garrettsworkshop/RAM2GS/(threads)

Thread 2 (2025-06-27):

Discrepancy between part# and voltage?

rdolbeau, 2025-06-27:
Hello,

Looking at your design (trying to figure out how you made work SDRAM with an Apple II - thanks for sharing!), there is something I do not understand on the wiring of the LCMXO2-640HC-4TG100C part in the LCMXO2 version.

The schematics indicates the aforementioned LCMXO2-640HC-4TG100C and point to the matching LCSC part.
However, the VCC for this part is wired to a 1.2V power supply.
But from my reading of the "MachXO2 Family Data Sheet", the HC variants require a 2.5V or 3.3V VCC, while the HE and ZE variants require a 1.2V VCC. I don't see a HE variant in the datasheet, there is some ZE though at a lower speed grades.

Is the intent to use a ZE part?

Cordially,
