garrettsworkshop/RAM2GS/Hardware/LCMXO/Documentation/RAM2GS.4201D.LCMXO-Schematic.pdf

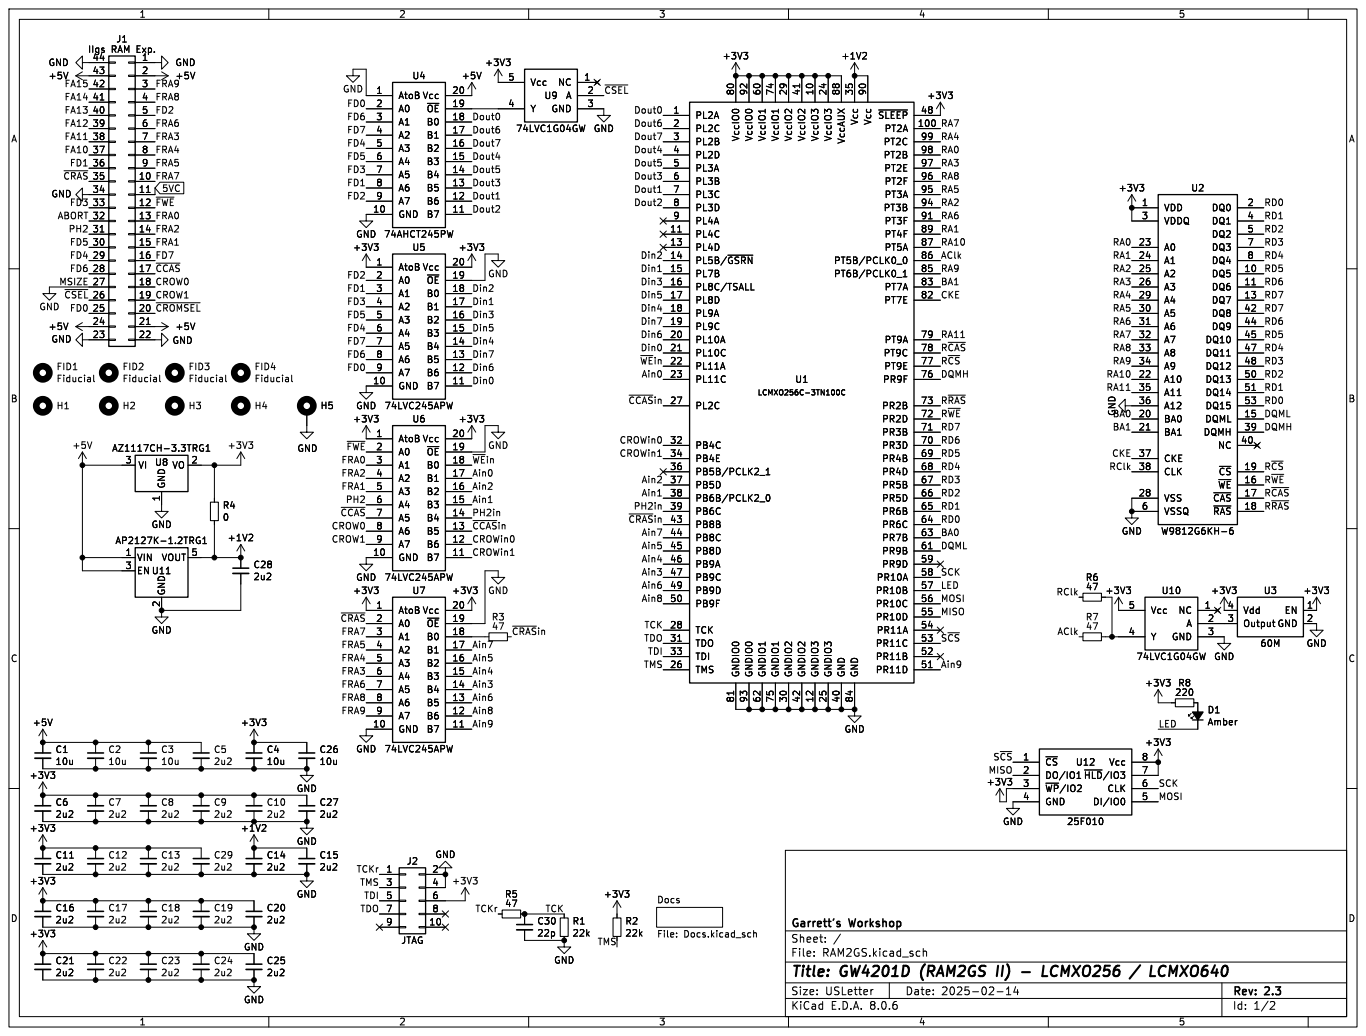
[picture p4: page 1]

File: RAM2GS.kicad_sch Sheet: / Garrett's Workshop Docs File: Docs.kicad_sch

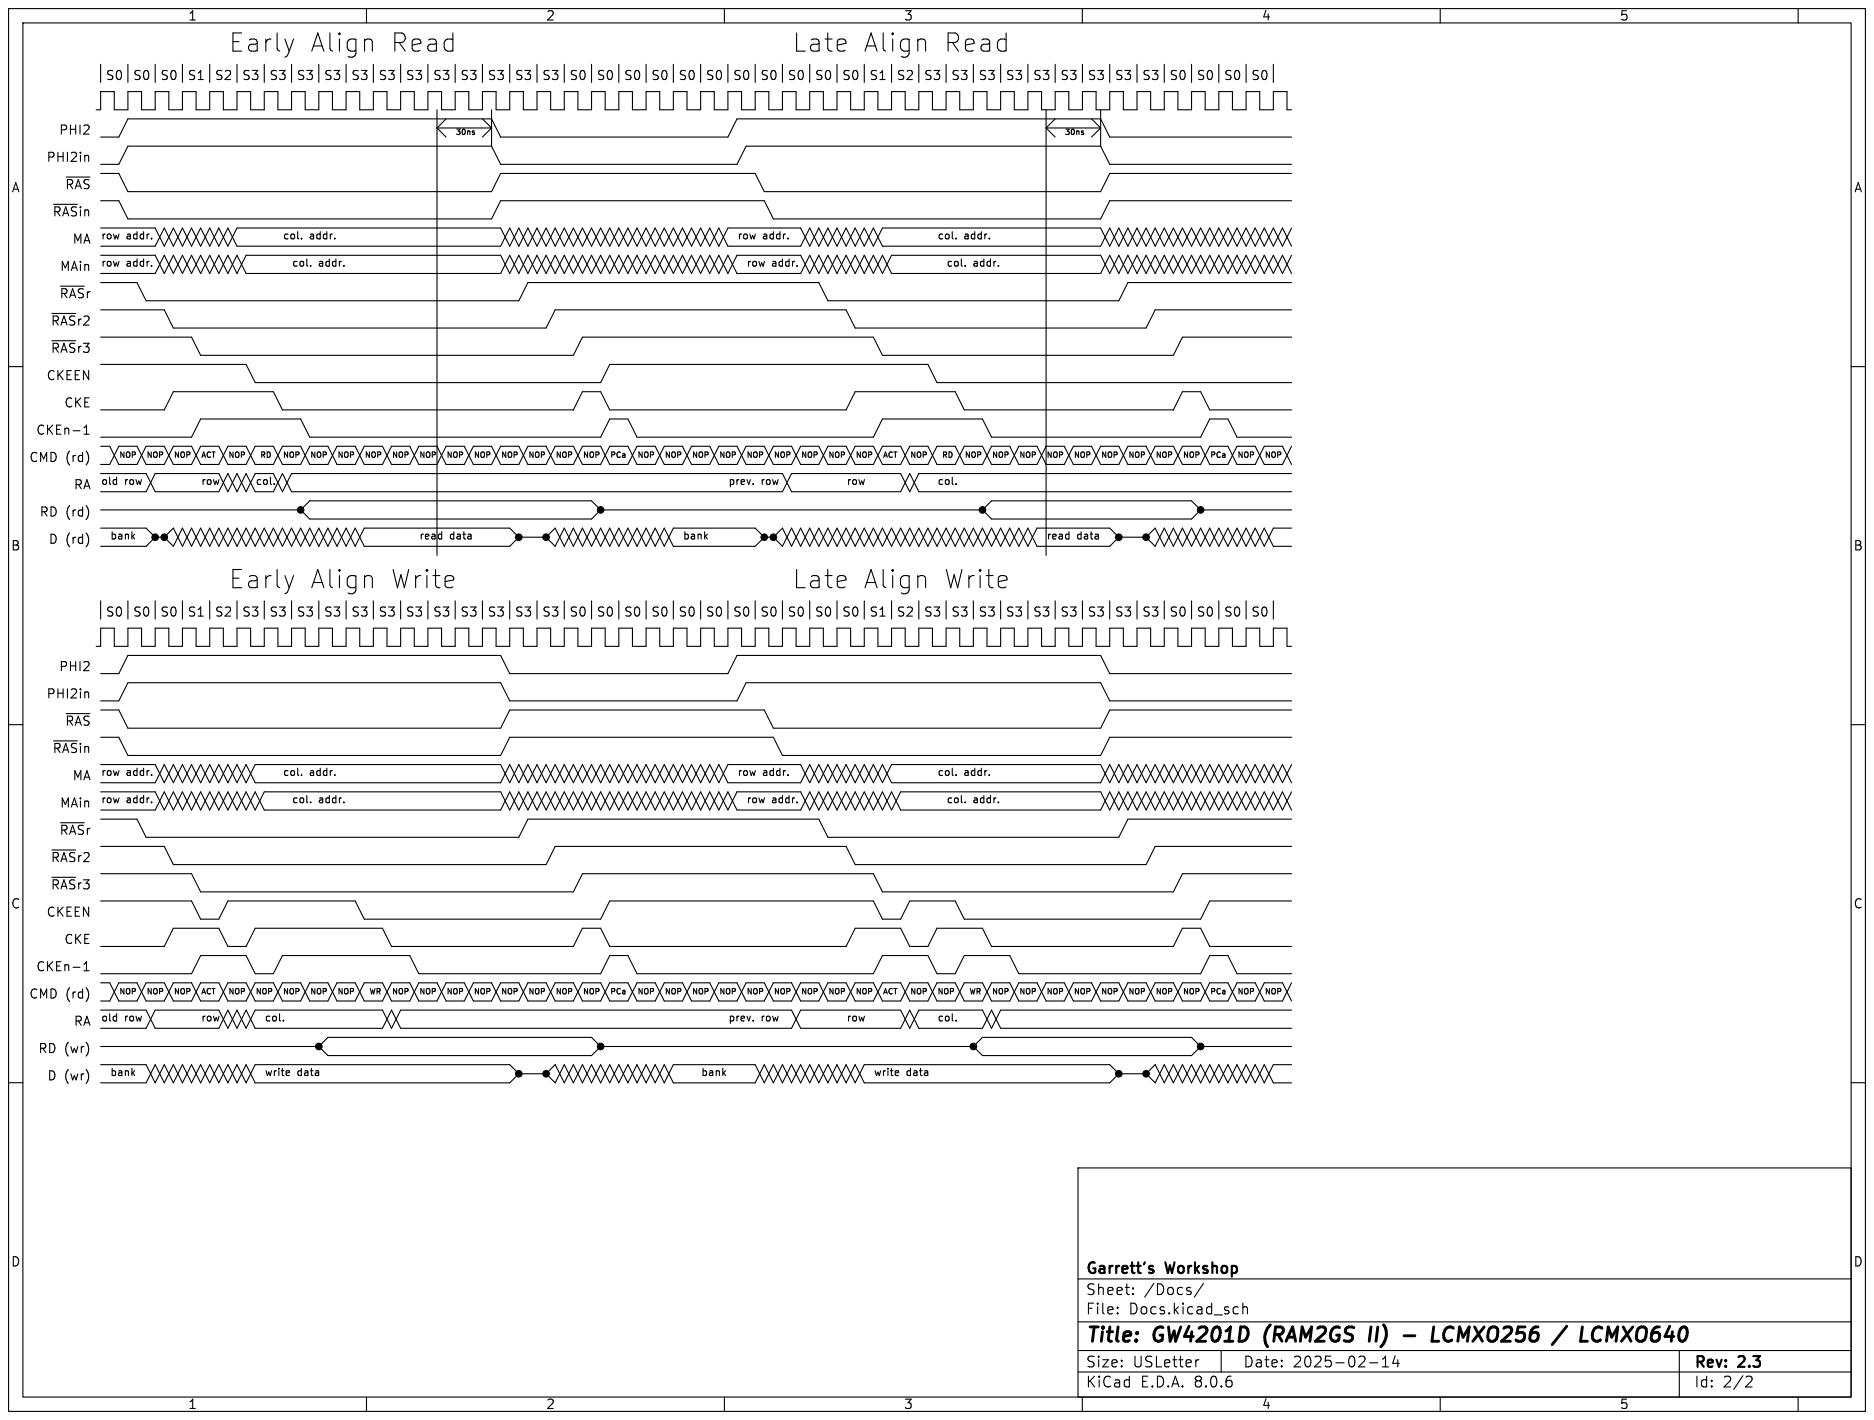
[picture p5: page 2]

col. addr. S3 S3 S3 S3 Early Align Write

~{RAS}r2 MAin ~{RAS}r CKEn-1 CKEEN

File: Docs.kicad_sch Sheet: /Docs/ Garrett's Workshop
