garrettsworkshop/RAM2GS/Hardware/LCMXO2/Documentation/RAM2GS.4201D.LCMXO2-Schematic.pdf

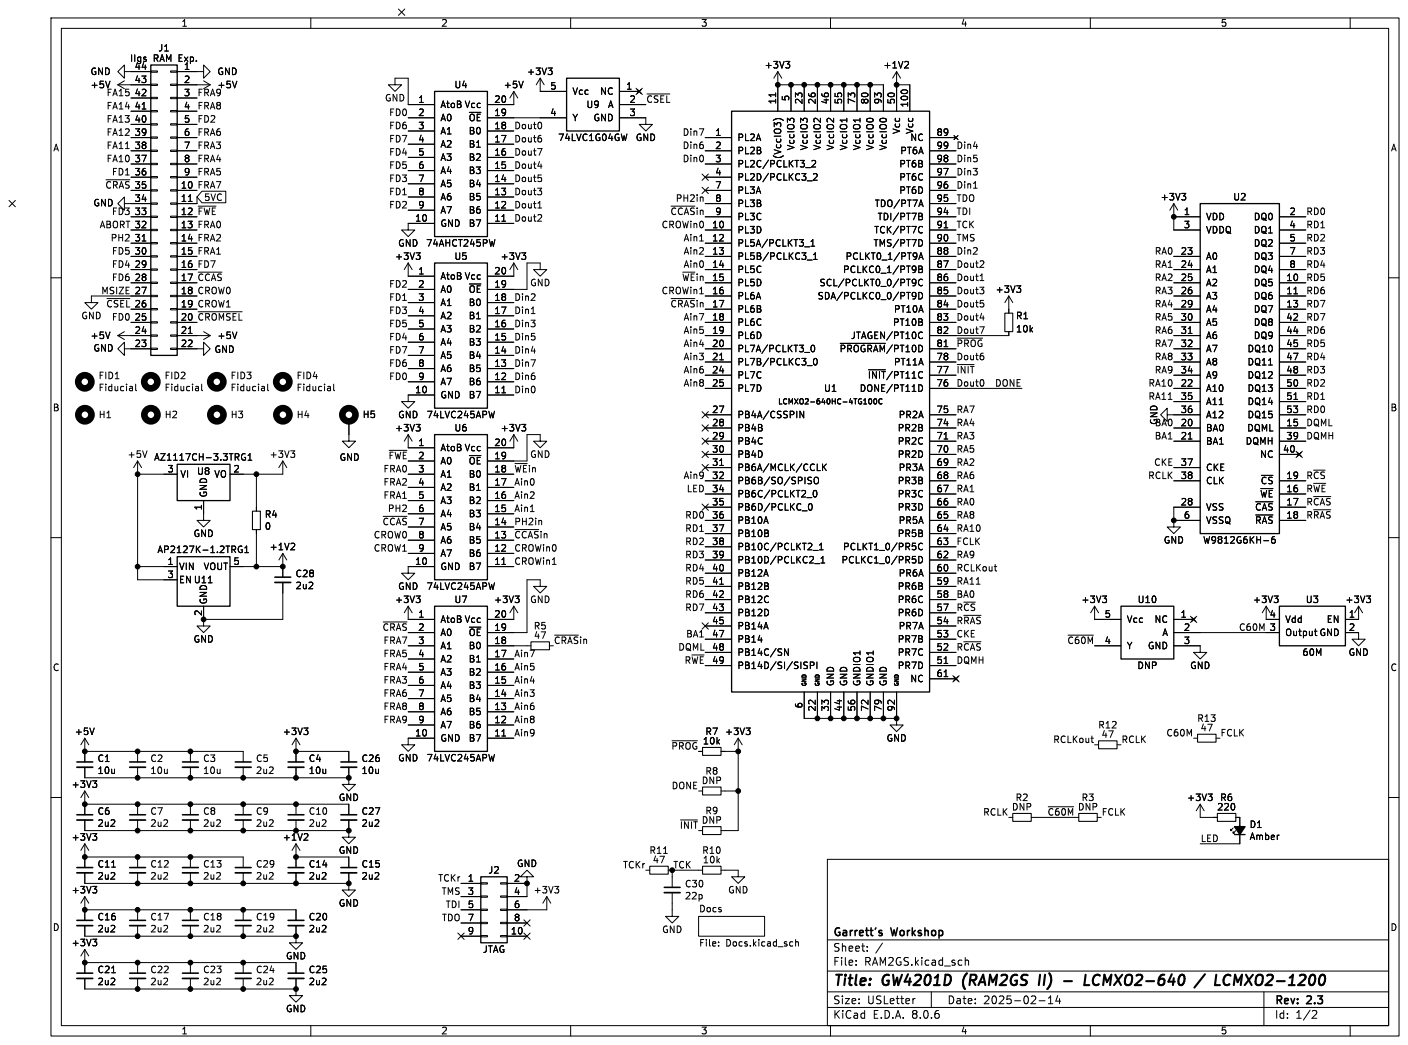
[picture p6: page 1]

5 Vcc 50 PR7D 51 PR7C 52 PR7B 53 PR7A 54 VccIO1 55 GNDIO1 56 PR6D 57 PR6C 58 PR6B 59 GND 6 PR6A 60 NC 61 PCLKC1_0/PR5D 62 PCLKT1_0/PR5C 63 PR5B 64 PR5A 65 PR3D 66 PR3C 67 PR3B 68 PR3A 69 PL3A 7 PR2D 70 PR2C 71 GNDIO1 72 VccIO1 73 PR2B 74 PR2A 75 DONE/PT11D 76 ~{INIT}/PT11C 77 PT11A 78 GND 79 PL3B 8 VccIO0 80

FID4 Fiducial C9

2 EN 3 VOUT 5 GND GND

File: RAM2GS.kicad_sch Sheet: / Garrett's Workshop Docs File: Docs.kicad_sch C23

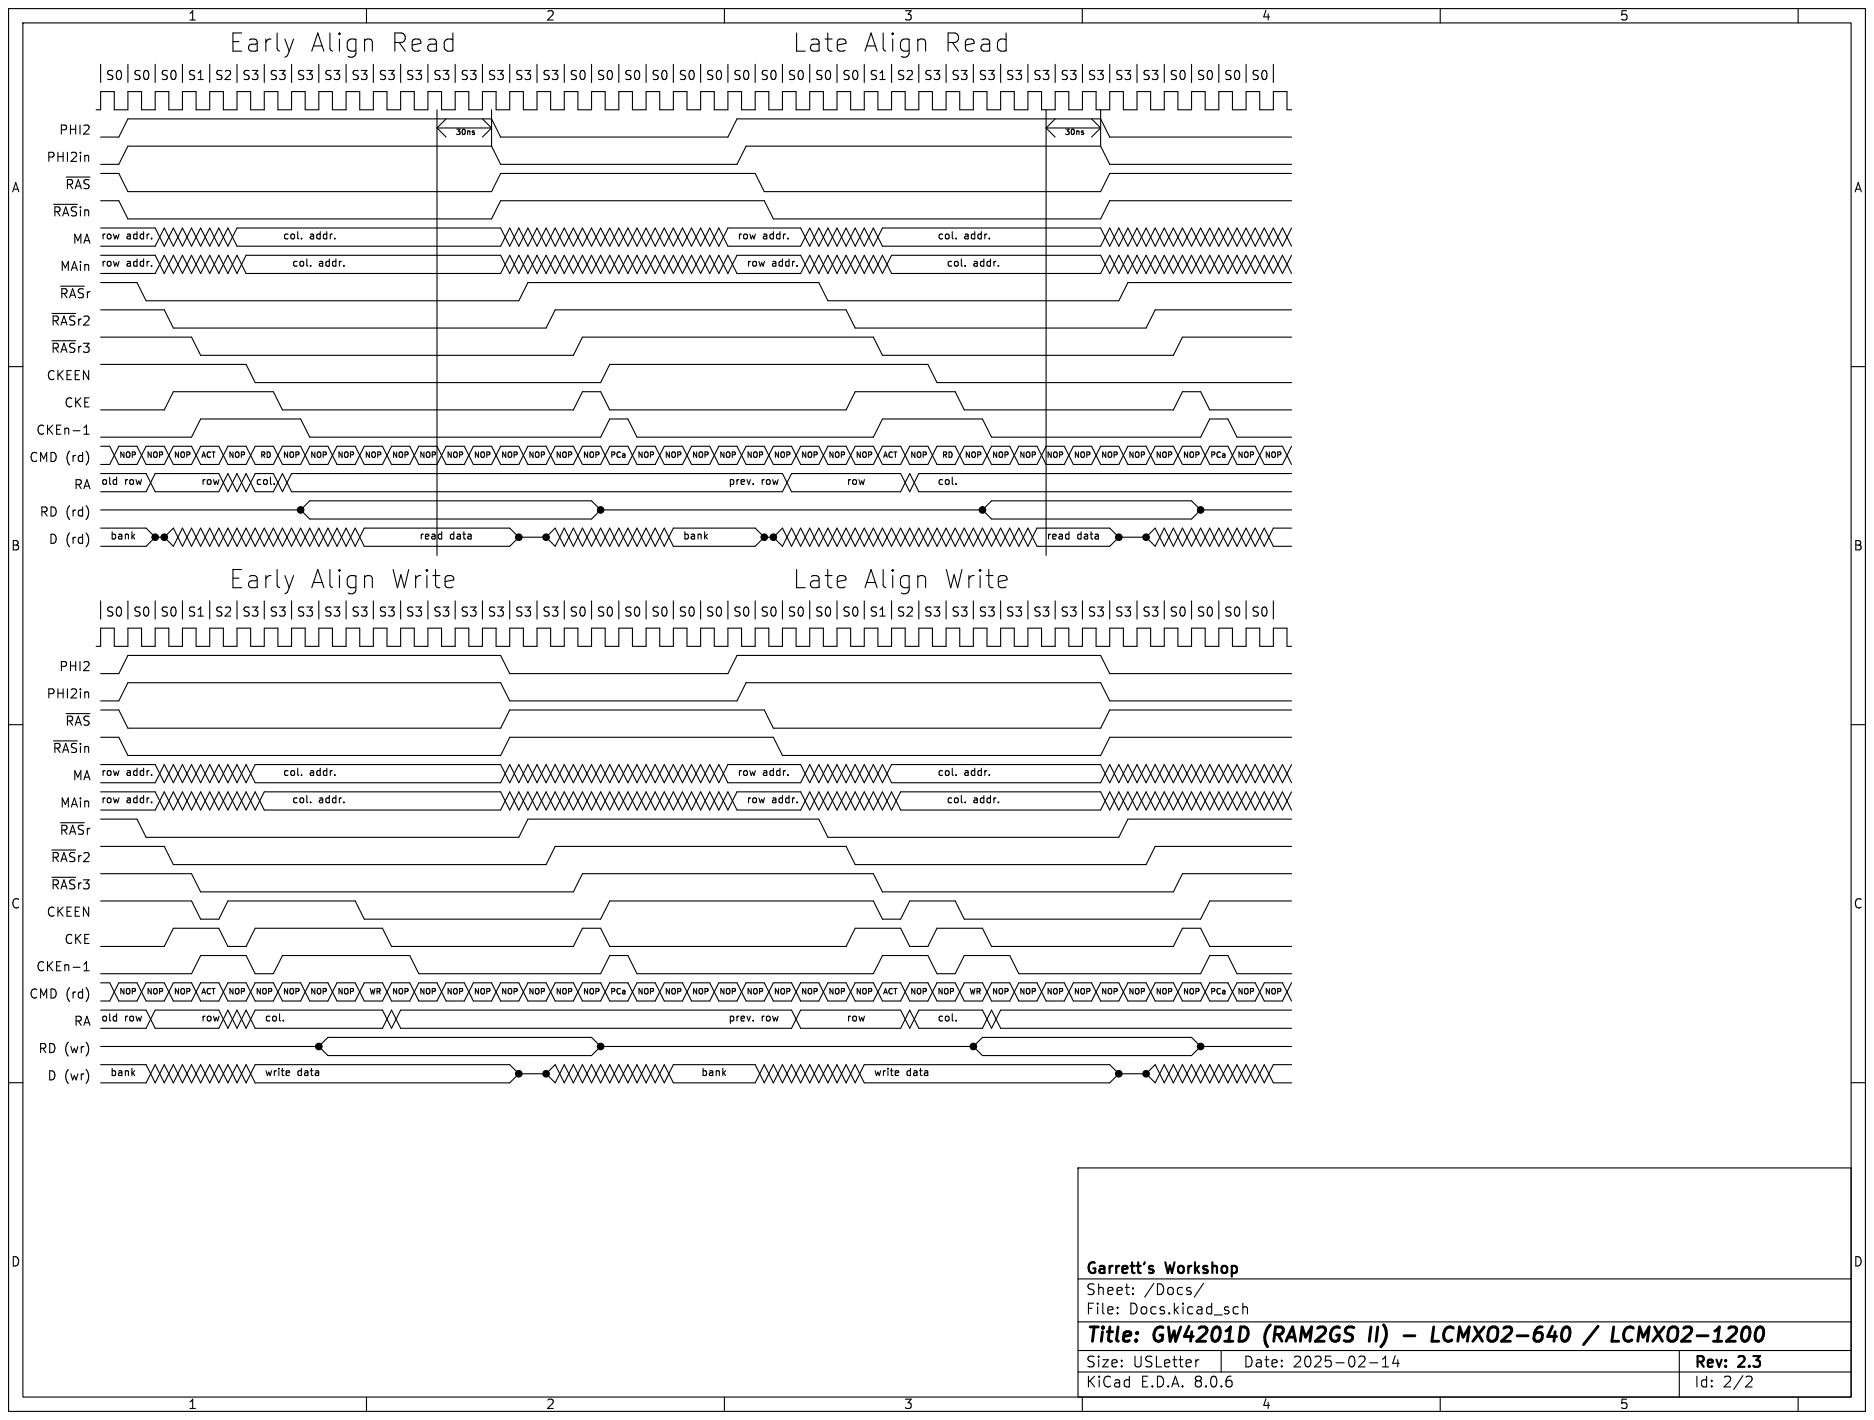
[picture p7: page 2]

~{RAS}r3S0 CKE CKEn-1 CMD (rd)

row addr. row addr. MAin row addr. ~{RAS}r MA row addr. S0 S1

col. addr. col. addr. S0

~{RAS}r2
NOP CKEn-1 ~{RAS}r3 CKEEN

File: Docs.kicad_sch Sheet: /Docs/ Garrett's Workshop
