garrettsworkshop/RAM2GS/Hardware/MAX/Documentation/RAM2GS.4201D.MAX-Schematic.pdf

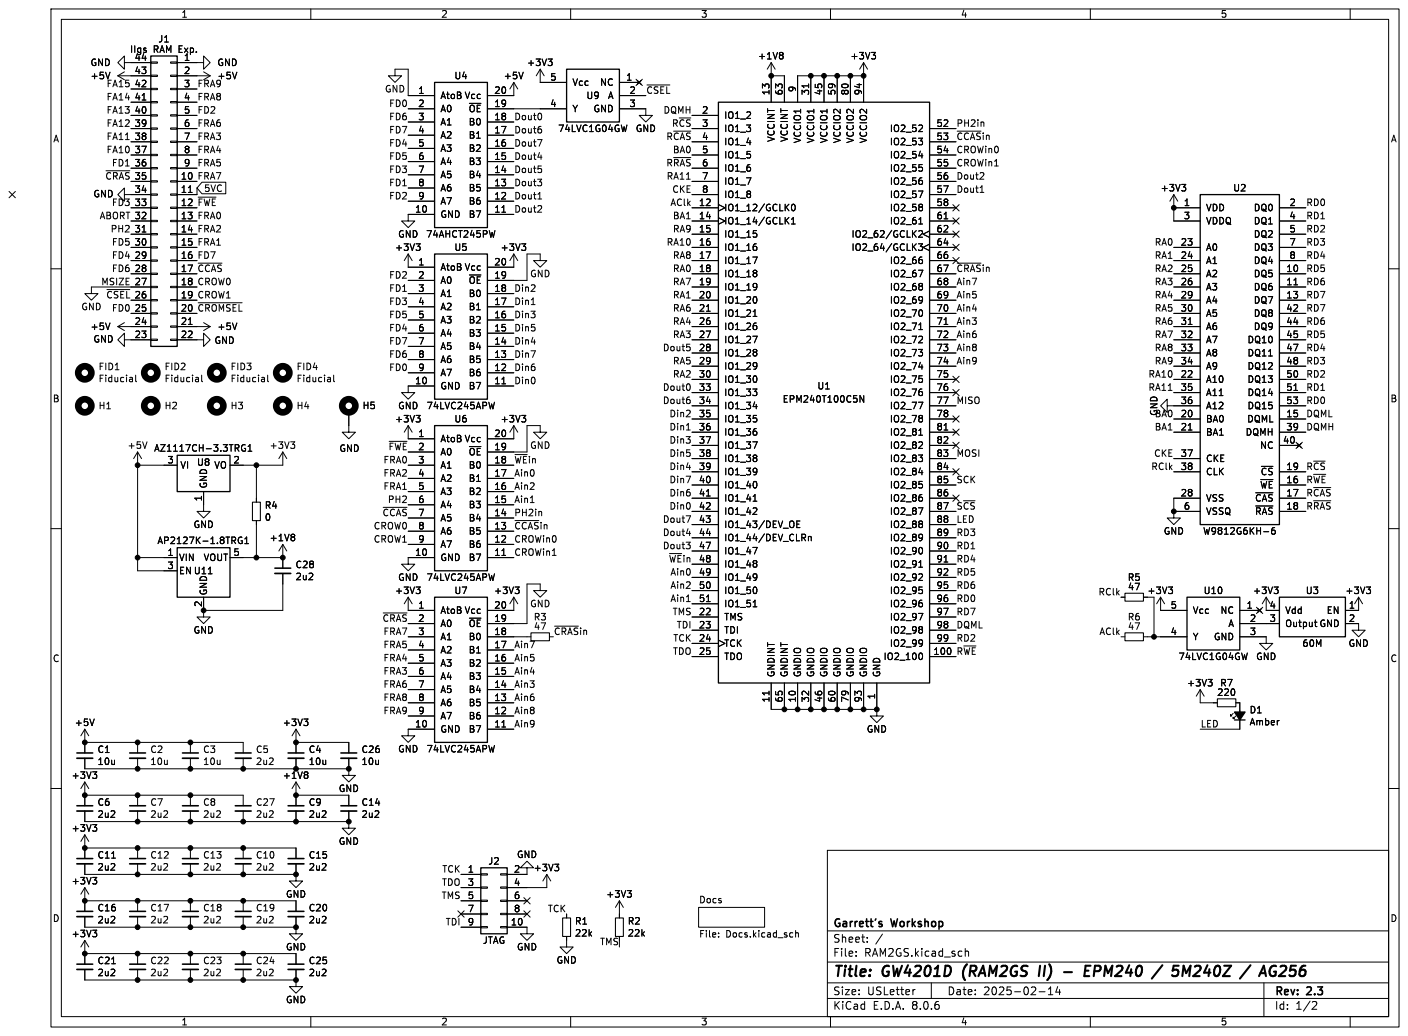
[picture p8: page 1]

R~{CAS} LED MOSI SCK

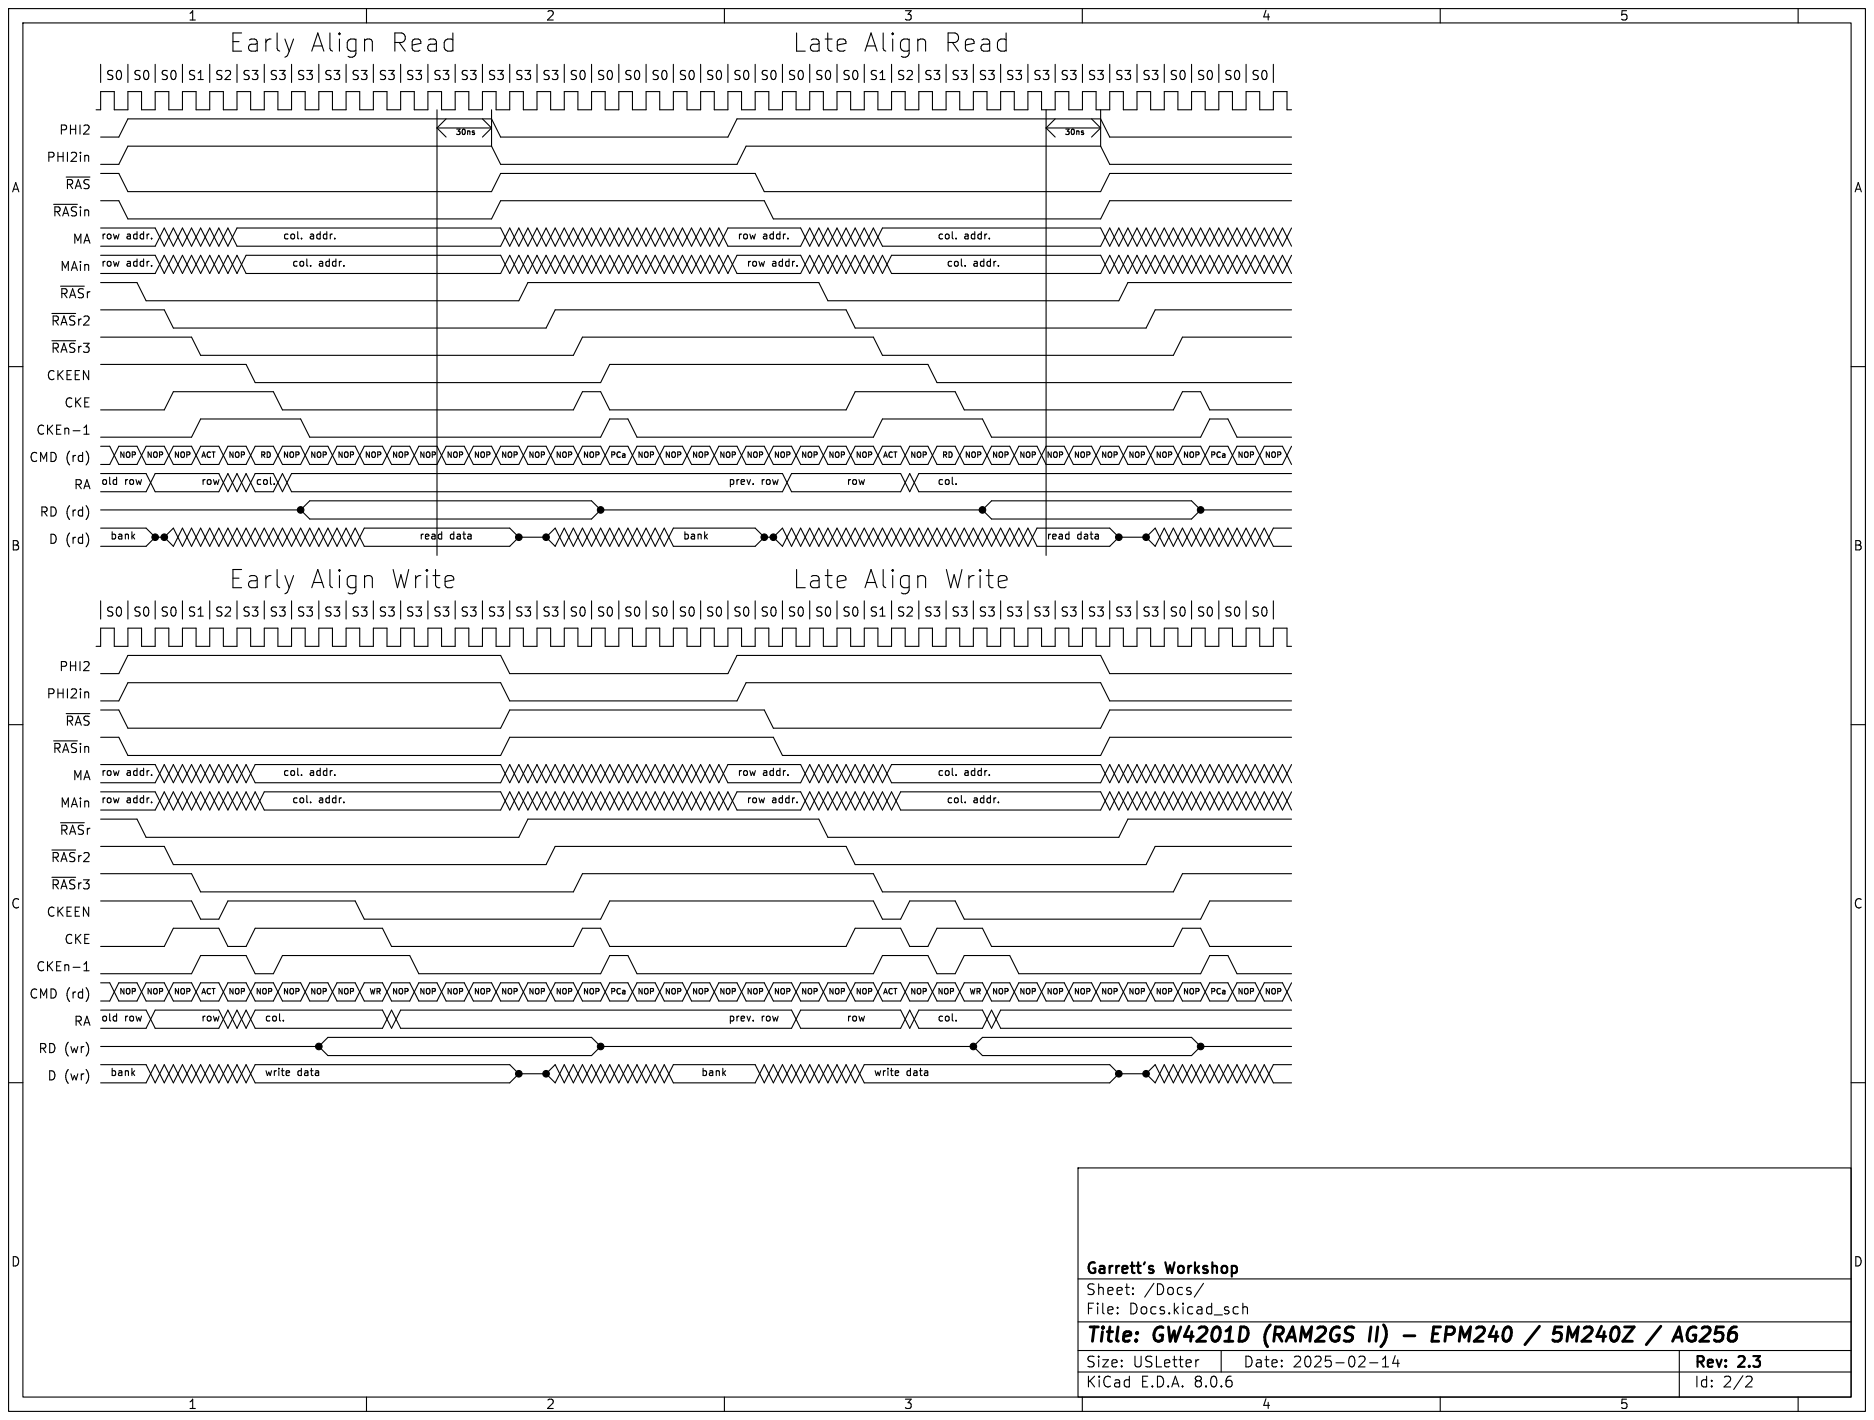
[picture p9: page 2]

PHI2 ~{RAS} MA MAin PHI2in ~{RAS}in

~{RAS}r3 MAin row addr. CKE CKEEN

row addr. row addr. ~{RAS}r2
~{RAS}r3 CKEn-1 RD (rd) RA

row addr.

col. addr. Early Align Write

File: Docs.kicad_sch Sheet: /Docs/ Garrett's Workshop
