garrettsworkshop/RAM2GS/Hardware/LCMXO/Documentation/RAM2GS.4201D.LCMXO-Placement.pdf

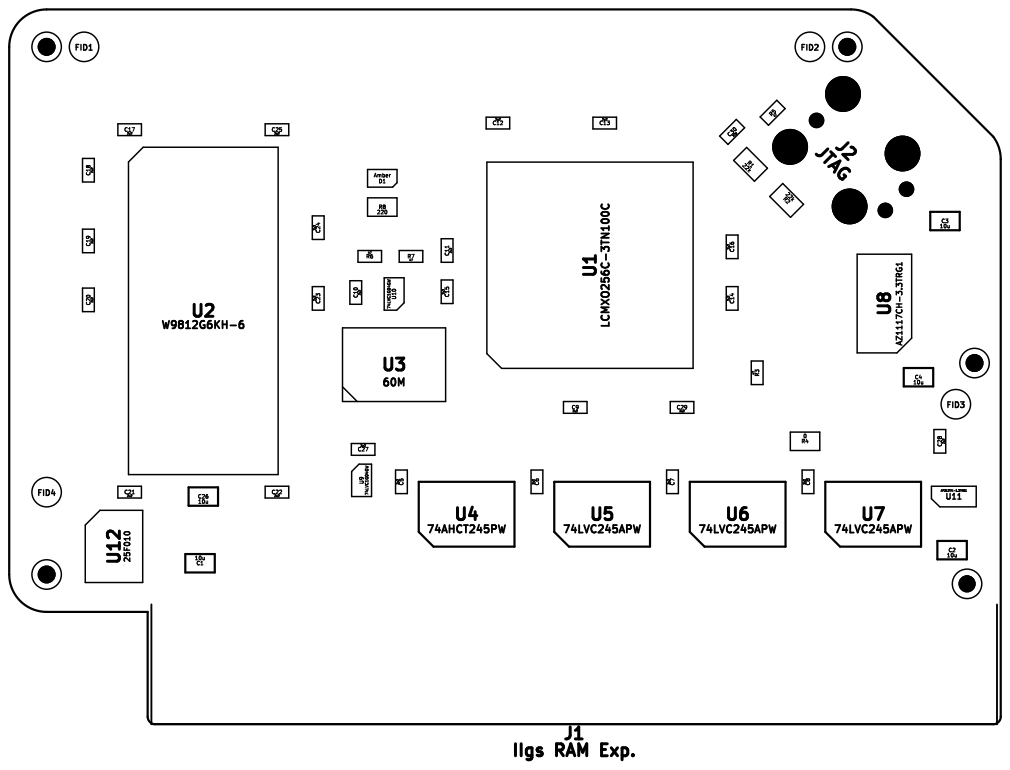
[picture p10: page 1]
