garrettsworkshop/RAM2GS/Hardware/LCMXO2/Documentation/RAM2GS.4201D.LCMXO2-Placement.pdf

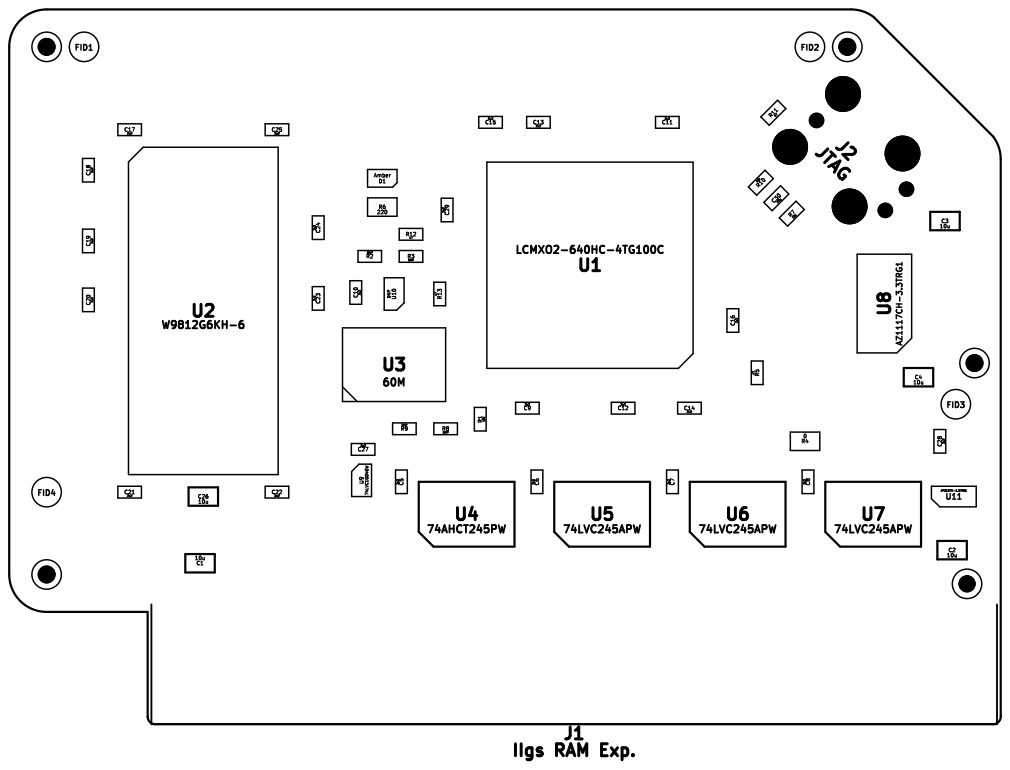
[picture p11: page 1]
