garrettsworkshop/RAM2GS/Hardware/MAX/Documentation/RAM2GS.4201D.MAX-Placement.pdf

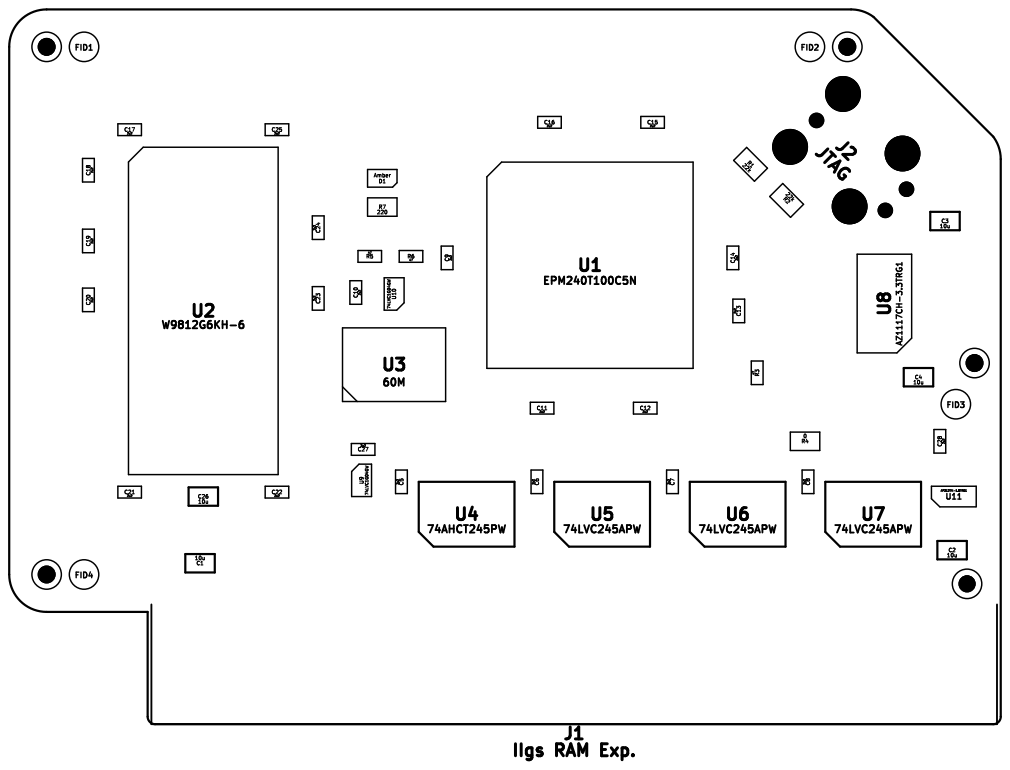
[picture p12: page 1]
