garrettsworkshop/RAM2GS/Hardware/MAX/RAM2GS.kicad_pcb

## KiCad design Hardware/MAX/RAM2GS.kicad_pcb (2025-02-23)

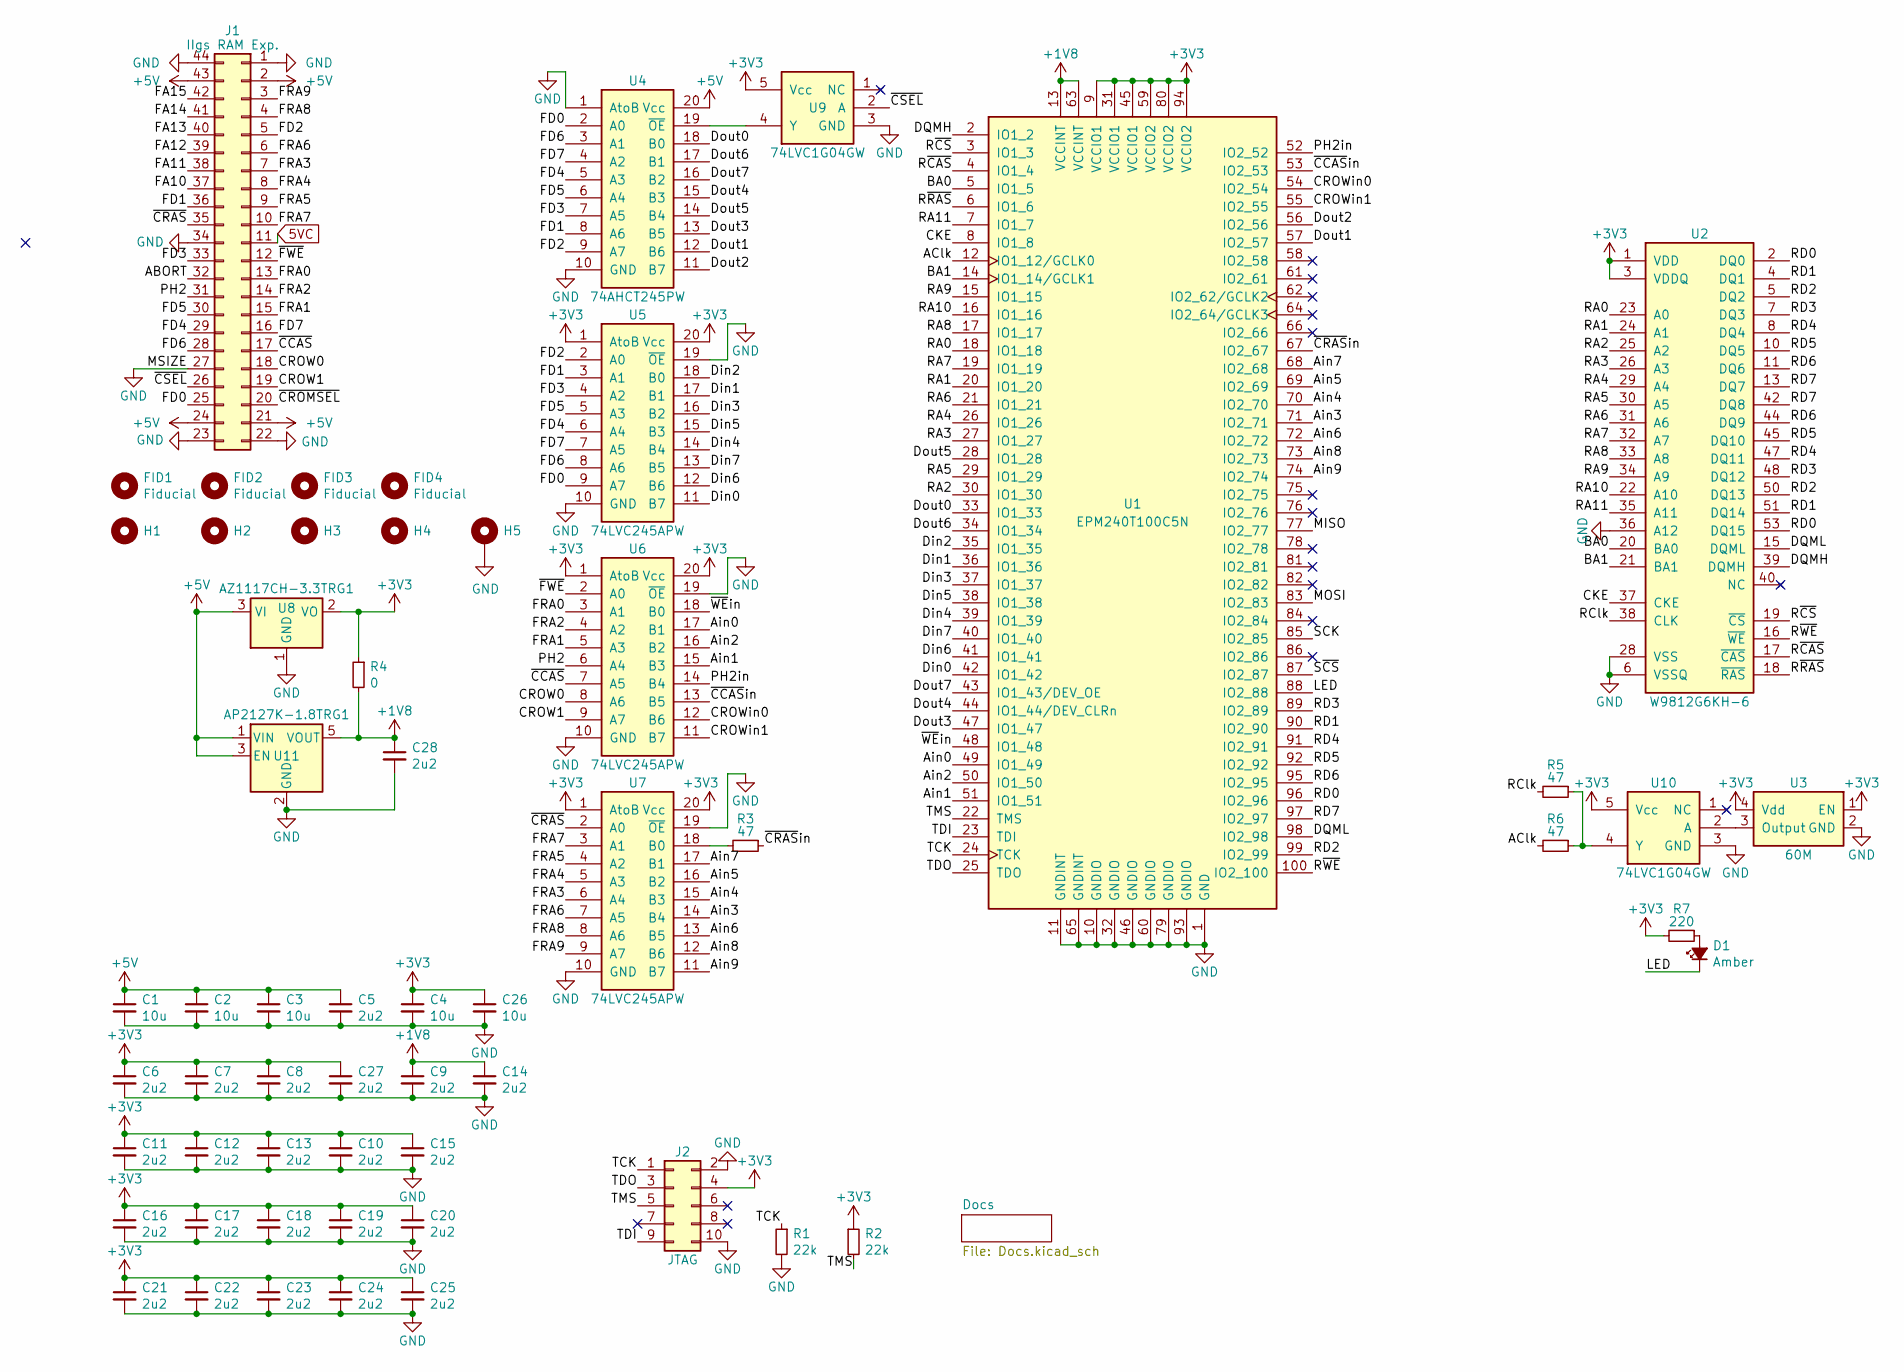
[picture p13: schematic RAM2GS.kicad_sch, GW4201D (RAM2GS II) - EPM240 / 5M240Z / AG256]

Parts:
C1, C2, C3, C4, C26: 10u; C_0805; LCSC Part C15850
C5, C6, C7, C8, C9, C10, C11, C12, C13, C14, C15, C16, C17, C18, C19, C20, C21, C22, C23, C24, C25, C27, C28: 2u2; C_0603; LCSC Part C23630
D1: Amber; LED_0805; LCSC Part C284932
FID1, FID2, FID3, FID4: Fiducial
H1, H2, H3, H4: PasteHole_1.152mm_NPTH
H5: PasteHole_1.1mm_PTH
J1: IIgs RAM Exp.; AppleIIgsMemoryExpansion_Edge
J2: JTAG; Tag-Connect_TC2050-IDC-FP_2x05_P1.27mm_Vertical
R1, R2: 22k; R_0805; LCSC Part C17560
R3, R5, R6: 47; R_0603; LCSC Part C23182
R4: 0; R_0805; LCSC Part C17477
R7: 220; R_0805; LCSC Part C17557
U1: EPM240T100C5N; TQFP-100_14x14mm_P0.5mm; LCSC Part C10041
U2: W9812G6KH-6; TSOP-II-54_22.2x10.16mm_P0.8mm; LCSC Part C62379
U3: 60M; Crystal_SMD_7050-4Pin_7.0x5.0mm_SiTime; LCSC Part C26255
U4: 74AHCT245PW; TSSOP-20_4.4x6.5mm_P0.65mm; LCSC Part C173388
U5, U6, U7: 74LVC245APW; TSSOP-20_4.4x6.5mm_P0.65mm; LCSC Part C6082
U8: AZ1117CH-3.3TRG1; SOT-223; LCSC Part C92102
U9, U10: 74LVC1G04GW; SOT-353; LCSC Part C10237
U11: AP2127K-1.8TRG1; SOT-23-5; LCSC Part C151375

Connections:
5VC: J1.11
+1V8: C9.1, C14.1, C28.1, R4.2, U1.13 (VCCINT), U1.63 (VCCINT), U11.5 (VOUT)
+3V3: C4.1, C6.1, C7.1, C8.1, C10.1, C11.1, C12.1, C13.1, C15.1, C16.1, C17.1, C18.1, C19.1, C20.1, C21.1, C22.1, C23.1, C24.1, C25.1, C26.1, C27.1, J2.4, R2.1, R4.1, R7.2, U1.9 (VCCIO1), U1.31 (VCCIO1), U1.45 (VCCIO1), U1.59 (VCCIO2), U1.80 (VCCIO2), U1.94 (VCCIO2), U2.1 (VDD), U2.3 (VDDQ), U2.9 (VDDQ), U2.14 (VDD), U2.27 (VDD), U2.43 (VDDQ), U2.49 (VDDQ), U3.1 (EN), U3.4 (Vdd), U5.1 (AtoB), U5.20 (Vcc), U6.1 (AtoB), U6.20 (Vcc), U7.1 (AtoB), U7.20 (Vcc), U8.2 (VO), U9.5 (Vcc), U10.5 (Vcc)
+5V: C1.1, C2.1, C3.1, C5.1, J1.2, J1.21, J1.24, J1.43, U4.20 (Vcc), U8.3 (VI), U11.1 (VIN), U11.3 (EN)
/ABORT: J1.32
/AClk: R6.2, U1.12 (IO1_12/GCLK0)
/Ain0: U1.49 (IO1_49), U6.17 (B1)
/Ain1: U1.51 (IO1_51), U6.15 (B3)
/Ain2: U1.50 (IO1_50), U6.16 (B2)
/Ain3: U1.71 (IO2_71), U7.14 (B4)
/Ain4: U1.70 (IO2_70), U7.15 (B3)
/Ain5: U1.69 (IO2_69), U7.16 (B2)
/Ain6: U1.72 (IO2_72), U7.13 (B5)
/Ain7: U1.68 (IO2_68), U7.17 (B1)
/Ain8: U1.73 (IO2_73), U7.12 (B6)
/Ain9: U1.74 (IO2_74), U7.11 (B7)
/BA0: U1.5 (IO1_5), U2.20 (BA0)
/BA1: U1.14 (IO1_14/GCLK1), U2.21 (BA1)
/CKE: U1.8 (IO1_8), U2.37 (CKE)
/CROW0: J1.18, U6.8 (A6)
/CROW1: J1.19, U6.9 (A7)
/CROWin0: U1.54 (IO2_54), U6.12 (B6)
/CROWin1: U1.55 (IO2_55), U6.11 (B7)
/DQMH: U1.2 (IO1_2), U2.39 (DQMH)
/DQML: U1.98 (IO2_98), U2.15 (DQML)
/Din0: U1.42 (IO1_42), U5.11 (B7)
/Din1: U1.36 (IO1_36), U5.17 (B1)
/Din2: U1.35 (IO1_35), U5.18 (B0)
/Din3: U1.37 (IO1_37), U5.16 (B2)
/Din4: U1.39 (IO1_39), U5.14 (B4)
/Din5: U1.38 (IO1_38), U5.15 (B3)
/Din6: U1.41 (IO1_41), U5.12 (B6)
/Din7: U1.40 (IO1_40), U5.13 (B5)
/Dout0: U1.33 (IO1_33), U4.18 (B0)
/Dout1: U1.57 (IO2_57), U4.12 (B6)
/Dout2: U1.56 (IO2_56), U4.11 (B7)
/Dout3: U1.47 (IO1_47), U4.13 (B5)
/Dout4: U1.44 (IO1_44/DEV_CLRn), U4.15 (B3)
/Dout5: U1.28 (IO1_28), U4.14 (B4)
/Dout6: U1.34 (IO1_34), U4.17 (B1)
/Dout7: U1.43 (IO1_43/DEV_OE), U4.16 (B2)
/FA10: J1.37
/FA11: J1.38
/FA12: J1.39
/FA13: J1.40
/FA14: J1.41
/FA15: J1.42
/FD0: J1.25, U4.2 (A0), U5.9 (A7)
/FD1: J1.36, U4.8 (A6), U5.3 (A1)
/FD2: J1.5, U4.9 (A7), U5.2 (A0)
/FD3: J1.33, U4.7 (A5), U5.4 (A2)
/FD4: J1.29, U4.5 (A3), U5.6 (A4)
/FD5: J1.30, U4.6 (A4), U5.5 (A3)
/FD6: J1.28, U4.3 (A1), U5.8 (A6)
/FD7: J1.16, U4.4 (A2), U5.7 (A5)
/FRA0: J1.13, U6.3 (A1)
/FRA1: J1.15, U6.5 (A3)
/FRA2: J1.14, U6.4 (A2)
/FRA3: J1.7, U7.6 (A4)
/FRA4: J1.8, U7.5 (A3)
/FRA5: J1.9, U7.4 (A2)
/FRA6: J1.6, U7.7 (A5)
/FRA7: J1.10, U7.3 (A1)
/FRA8: J1.4, U7.8 (A6)
/FRA9: J1.3, U7.9 (A7)
/LED: D1.1 (K), U1.88 (IO2_88)
/MISO: U1.77 (IO2_77)
/MOSI: U1.83 (IO2_83)
/PH2: J1.31, U6.6 (A4)
/PH2in: U1.52 (IO2_52), U6.14 (B4)
/RA0: U1.18 (IO1_18), U2.23 (A0)
/RA1: U1.20 (IO1_20), U2.24 (A1)
/RA2: U1.30 (IO1_30), U2.25 (A2)
/RA3: U1.27 (IO1_27), U2.26 (A3)
/RA4: U1.26 (IO1_26), U2.29 (A4)
/RA5: U1.29 (IO1_29), U2.30 (A5)
/RA6: U1.21 (IO1_21), U2.31 (A6)
/RA7: U1.19 (IO1_19), U2.32 (A7)
/RA8: U1.17 (IO1_17), U2.33 (A8)
/RA9: U1.15 (IO1_15), U2.34 (A9)
/RA10: U1.16 (IO1_16), U2.22 (A10)
/RA11: U1.7 (IO1_7), U2.35 (A11)
/RClk: R5.2, U2.38 (CLK)
/RD0: U1.96 (IO2_96), U2.2 (DQ0), U2.53 (DQ15)
/RD1: U1.90 (IO2_90), U2.4 (DQ1), U2.51 (DQ14)
/RD2: U1.99 (IO2_99), U2.5 (DQ2), U2.50 (DQ13)
/RD3: U1.89 (IO2_89), U2.7 (DQ3), U2.48 (DQ12)
/RD4: U1.91 (IO2_91), U2.8 (DQ4), U2.47 (DQ11)
/RD5: U1.92 (IO2_92), U2.10 (DQ5), U2.45 (DQ10)
/RD6: U1.95 (IO2_95), U2.11 (DQ6), U2.44 (DQ9)
/RD7: U1.97 (IO2_97), U2.13 (DQ7), U2.42 (DQ8)
/R~CAS: U1.4 (IO1_4), U2.17 (~CAS)
/R~CS: U1.3 (IO1_3), U2.19 (~CS)
/R~RAS: U1.6 (IO1_6), U2.18 (~RAS)
/R~WE: U1.100 (IO2_100), U2.16 (~WE)
/SCK: U1.85 (IO2_85)
/S~CS: U1.87 (IO2_87)
/TCK: J2.1, R1.1, U1.24 (TCK)
/TDI: J2.9, U1.23 (TDI)
/TDO: J2.3, U1.25 (TDO)
/TMS: J2.5, R2.2, U1.22 (TMS)
/~CCAS: J1.17, U6.7 (A5)
/~CCASin: U1.53 (IO2_53), U6.13 (B5)
/~CRAS: J1.35, U7.2 (A0)
/~CRASin: R3.1, U1.67 (IO2_67)
/~CROMSEL: J1.20
/~CSEL: J1.26, U9.2 (A)
/~FWE: J1.12, U6.2 (A0)
/~WEin: U1.48 (IO1_48), U6.18 (B0)
GND: C1.2, C2.2, C3.2, C4.2, C5.2, C6.2, C7.2, C8.2, C9.2, C10.2, C11.2, C12.2, C13.2, C14.2, C15.2, C16.2, C17.2, C18.2, C19.2, C20.2, C21.2, C22.2, C23.2, C24.2, C25.2, C26.2, C27.2, C28.2, H5.1, J1.1, J1.22, J1.23, J1.27, J1.34, J1.44, J2.2, J2.10, R1.2, U1.1 (GND), U1.10 (GNDIO), U1.11 (GNDINT), U1.32 (GNDIO), U1.46 (GNDIO), U1.60 (GNDIO), U1.65 (GNDINT), U1.79 (GNDIO), U1.93 (GNDIO), U2.6 (VSSQ), U2.12 (VSSQ), U2.28 (VSS), U2.36 (A12), U2.41 (VSS), U2.46 (VSSQ), U2.52 (VSSQ), U2.54 (VSS), U3.2 (GND), U4.1 (AtoB), U4.10 (GND), U5.10 (GND), U5.19 (~OE), U6.10 (GND), U6.19 (~OE), U7.10 (GND), U7.19 (~OE), U8.1 (GND), U9.3 (GND), U10.3 (GND), U11.2 (GND)
unnamed: D1.2 (A), R7.1
unnamed: U4.19 (~OE), U9.4 (Y)
unnamed: R3.2, U7.18 (B0)
unnamed: U3.3 (Output), U10.2 (A)
unnamed: R5.1, R6.1, U10.4 (Y)

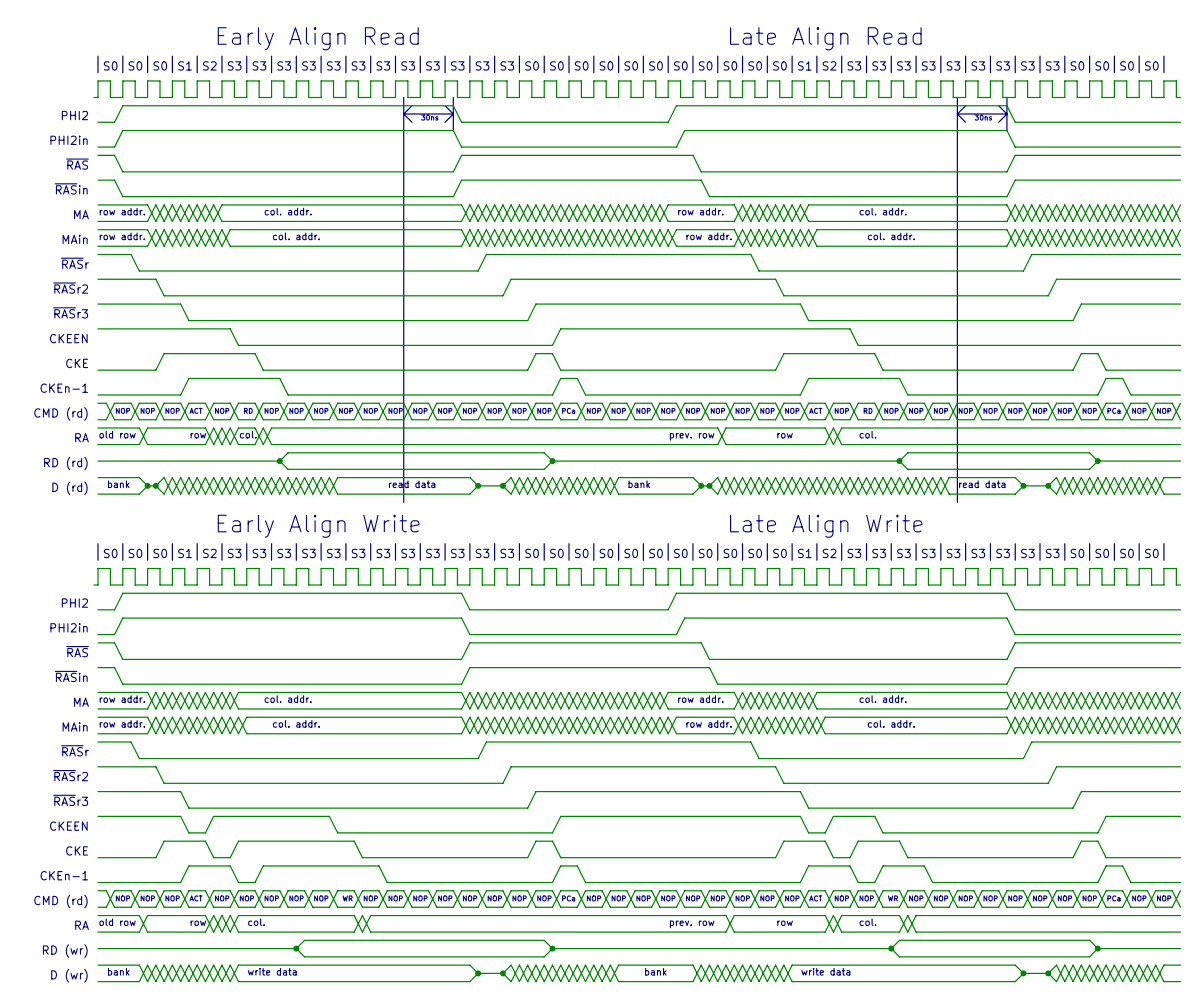
[picture p14: schematic Docs.kicad_sch, GW4201D (RAM2GS II) - EPM240 / 5M240Z / AG256]

Notes on the sheet:
NOP
~{RAS}r3
col.
30ns
~{RAS}r
~{RAS}in
Early Align Read
D (rd)
col. addr.
row addr.
prev. row
CKEn-1
PHI2
MAin
bank
~{RAS}r2
CMD (rd)
read data
Late Align Write
row
PHI2in
RD (wr)
PCa
write data
CKEEN
RD (rd)
Late Align Read
D (wr)
ACT
~{RAS}
CKE
old row
Early Align Write

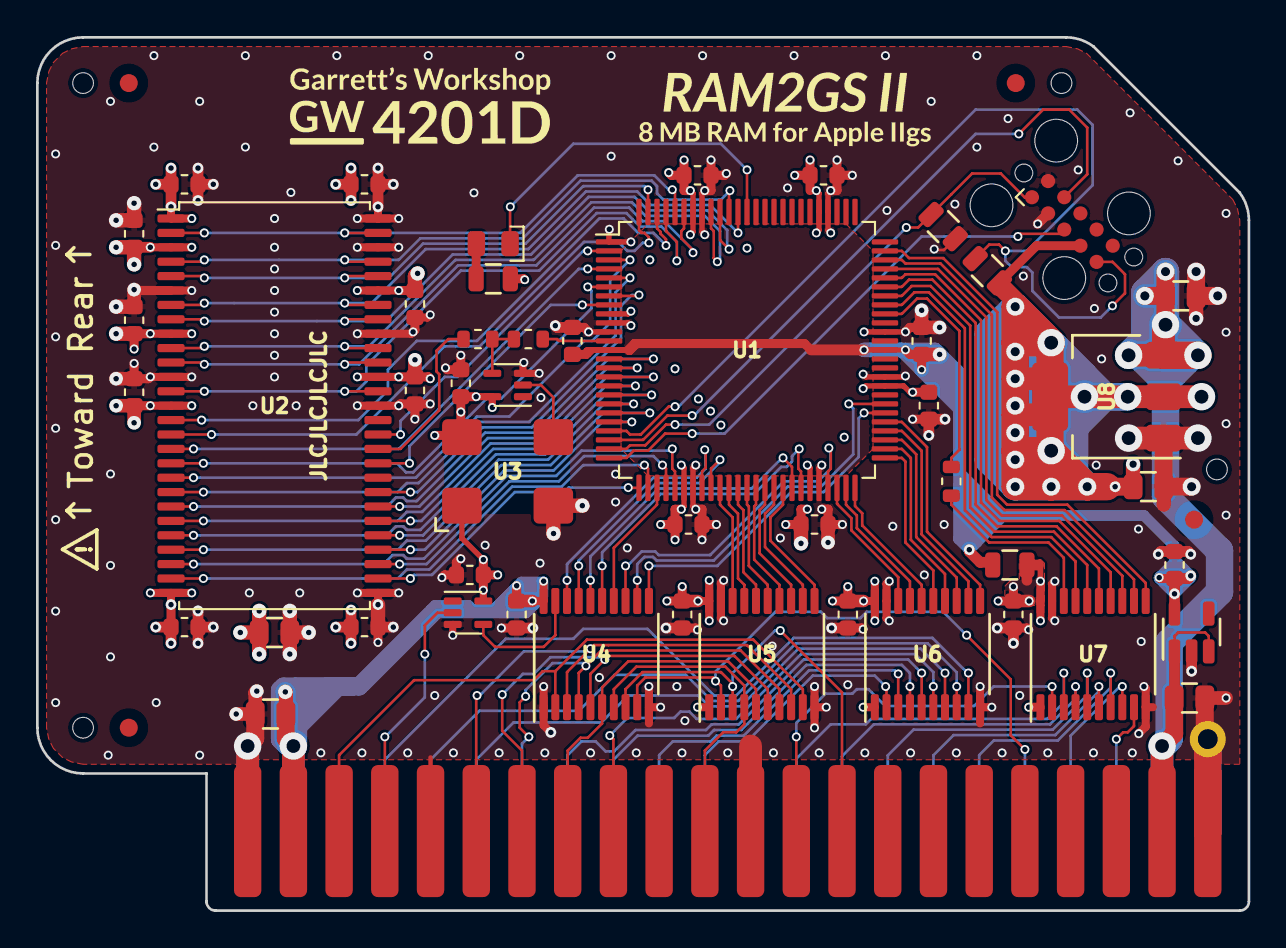
[picture p15: board Hardware/MAX/RAM2GS.kicad_pcb from above]

Board: 4 copper layers, 67.3 x 48.5 mm, 58 parts (0 on the bottom side), 102 nets.
