garrettsworkshop/RAM2GS/Hardware/LCMXO2/RAM2GS.kicad_pcb

## KiCad design Hardware/LCMXO2/RAM2GS.kicad_pcb (2025-02-23)

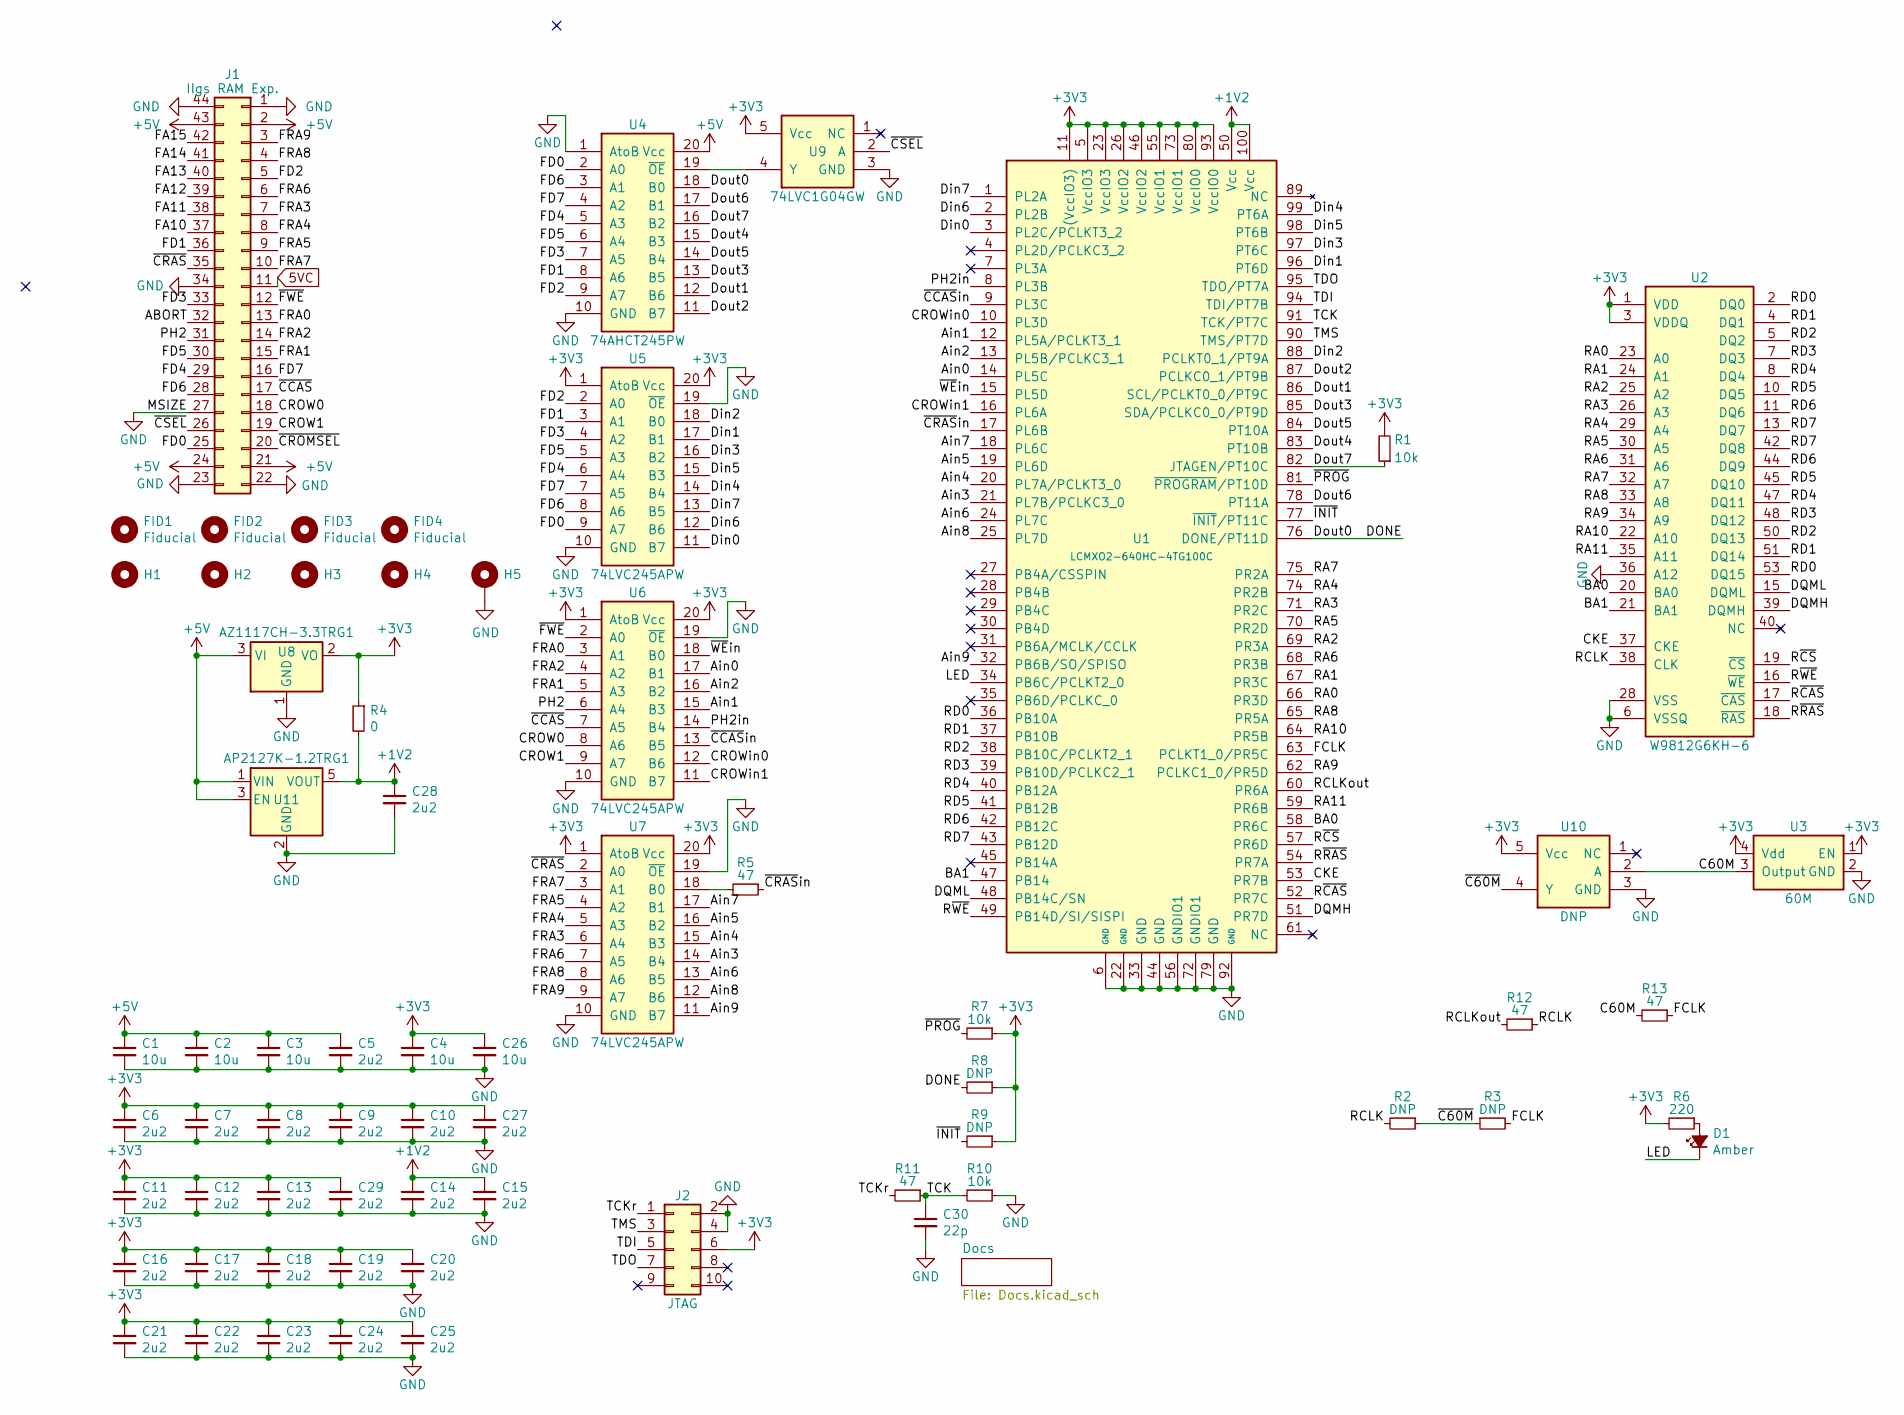
[picture p16: schematic RAM2GS.kicad_sch, GW4201D (RAM2GS II) - LCMXO2-640 / LCMXO2-1200]

Parts:
C1, C2, C3, C4, C26: 10u; C_0805; LCSC Part C15850
C5, C6, C7, C8, C9, C10, C11, C12, C13, C14, C15, C16, C17, C18, C19, C20, C21, C22, C23, C24, C25, C27, C28, C29: 2u2; C_0603; LCSC Part C23630
C30: 22p; C_0603; LCSC Part C1653
D1: Amber; LED_0805; LCSC Part C284932
FID1, FID2, FID3, FID4: Fiducial
H1, H2, H3, H4: PasteHole_1.152mm_NPTH
H5: PasteHole_1.1mm_PTH
J1: IIgs RAM Exp.; AppleIIgsMemoryExpansion_Edge
J2: JTAG; Tag-Connect_TC2050-IDC-FP_2x05_P1.27mm_Vertical
R1, R7, R10: 10k; R_0603; LCSC Part C25804
R2, R3, R8, R9: DNP; R_0603
R4: 0; R_0805; LCSC Part C17477
R5, R11, R12, R13: 47; R_0603; LCSC Part C23182
R6: 220; R_0805; LCSC Part C17557
U1: LCMXO2-640HC-4TG100C; TQFP-100_14x14mm_P0.5mm; LCSC Part C1519051
U2: W9812G6KH-6; TSOP-II-54_22.2x10.16mm_P0.8mm; LCSC Part C62379
U3: 60M; Crystal_SMD_7050-4Pin_7.0x5.0mm_SiTime; LCSC Part C26255
U4: 74AHCT245PW; TSSOP-20_4.4x6.5mm_P0.65mm; LCSC Part C173388
U5, U6, U7: 74LVC245APW; TSSOP-20_4.4x6.5mm_P0.65mm; LCSC Part C6082
U8: AZ1117CH-3.3TRG1; SOT-223; LCSC Part C92102
U9: 74LVC1G04GW; SOT-353; LCSC Part C10237
U10: DNP; SOT-353
U11: AP2127K-1.2TRG1; SOT-23-5; LCSC Part C151376

Connections:
5VC: J1.11
+1V2: C14.1, C15.1, C28.1, R4.2, U1.50 (Vcc), U1.100 (Vcc), U11.5 (VOUT)
+3V3: C4.1, C6.1, C7.1, C8.1, C9.1, C10.1, C11.1, C12.1, C13.1, C16.1, C17.1, C18.1, C19.1, C20.1, C21.1, C22.1, C23.1, C24.1, C25.1, C26.1, C27.1, C29.1, J2.6, R1.2, R4.1, R6.2, R7.1, R8.1, R9.1, U1.5 (VccIO3), U1.11 ((VccIO3)), U1.23 (VccIO3), U1.26 (VccIO2), U1.46 (VccIO2), U1.55 (VccIO1), U1.73 (VccIO1), U1.80 (VccIO0), U1.93 (VccIO0), U2.1 (VDD), U2.3 (VDDQ), U2.9 (VDDQ), U2.14 (VDD), U2.27 (VDD), U2.43 (VDDQ), U2.49 (VDDQ), U3.1 (EN), U3.4 (Vdd), U5.1 (AtoB), U5.20 (Vcc), U6.1 (AtoB), U6.20 (Vcc), U7.1 (AtoB), U7.20 (Vcc), U8.2 (VO), U9.5 (Vcc), U10.5 (Vcc)
+5V: C1.1, C2.1, C3.1, C5.1, J1.2, J1.21, J1.24, J1.43, U4.20 (Vcc), U8.3 (VI), U11.1 (VIN), U11.3 (EN)
/ABORT: J1.32
/Ain0: U1.14 (PL5C), U6.17 (B1)
/Ain1: U1.12 (PL5A/PCLKT3_1), U6.15 (B3)
/Ain2: U1.13 (PL5B/PCLKC3_1), U6.16 (B2)
/Ain3: U1.21 (PL7B/PCLKC3_0), U7.14 (B4)
/Ain4: U1.20 (PL7A/PCLKT3_0), U7.15 (B3)
/Ain5: U1.19 (PL6D), U7.16 (B2)
/Ain6: U1.24 (PL7C), U7.13 (B5)
/Ain7: U1.18 (PL6C), U7.17 (B1)
/Ain8: U1.25 (PL7D), U7.12 (B6)
/Ain9: U1.32 (PB6B/SO/SPISO), U7.11 (B7)
/BA0: U1.58 (PR6C), U2.20 (BA0)
/BA1: U1.47 (PB14), U2.21 (BA1)
/C60M: R13.2, U3.3 (Output), U10.2 (A)
/CKE: U1.53 (PR7B), U2.37 (CKE)
/CROW0: J1.18, U6.8 (A6)
/CROW1: J1.19, U6.9 (A7)
/CROWin0: U1.10 (PL3D), U6.12 (B6)
/CROWin1: U1.16 (PL6A), U6.11 (B7)
/DONE: R8.2, U1.76 (DONE/PT11D), U4.18 (B0)
/DQMH: U1.51 (PR7D), U2.39 (DQMH)
/DQML: U1.48 (PB14C/SN), U2.15 (DQML)
/Din0: U1.3 (PL2C/PCLKT3_2), U5.11 (B7)
/Din1: U1.96 (PT6D), U5.17 (B1)
/Din2: U1.88 (PCLKT0_1/PT9A), U5.18 (B0)
/Din3: U1.97 (PT6C), U5.16 (B2)
/Din4: U1.99 (PT6A), U5.14 (B4)
/Din5: U1.98 (PT6B), U5.15 (B3)
/Din6: U1.2 (PL2B), U5.12 (B6)
/Din7: U1.1 (PL2A), U5.13 (B5)
/Dout1: U1.86 (SCL/PCLKT0_0/PT9C), U4.12 (B6)
/Dout2: U1.87 (PCLKC0_1/PT9B), U4.11 (B7)
/Dout3: U1.85 (SDA/PCLKC0_0/PT9D), U4.13 (B5)
/Dout4: U1.83 (PT10B), U4.15 (B3)
/Dout5: U1.84 (PT10A), U4.14 (B4)
/Dout6: U1.78 (PT11A), U4.17 (B1)
/Dout7: R1.1, U1.82 (JTAGEN/PT10C), U4.16 (B2)
/FA10: J1.37
/FA11: J1.38
/FA12: J1.39
/FA13: J1.40
/FA14: J1.41
/FA15: J1.42
/FCLK: R3.2, R13.1, U1.63 (PCLKT1_0/PR5C)
/FD0: J1.25, U4.2 (A0), U5.9 (A7)
/FD1: J1.36, U4.8 (A6), U5.3 (A1)
/FD2: J1.5, U4.9 (A7), U5.2 (A0)
/FD3: J1.33, U4.7 (A5), U5.4 (A2)
/FD4: J1.29, U4.5 (A3), U5.6 (A4)
/FD5: J1.30, U4.6 (A4), U5.5 (A3)
/FD6: J1.28, U4.3 (A1), U5.8 (A6)
/FD7: J1.16, U4.4 (A2), U5.7 (A5)
/FRA0: J1.13, U6.3 (A1)
/FRA1: J1.15, U6.5 (A3)
/FRA2: J1.14, U6.4 (A2)
/FRA3: J1.7, U7.6 (A4)
/FRA4: J1.8, U7.5 (A3)
/FRA5: J1.9, U7.4 (A2)
/FRA6: J1.6, U7.7 (A5)
/FRA7: J1.10, U7.3 (A1)
/FRA8: J1.4, U7.8 (A6)
/FRA9: J1.3, U7.9 (A7)
/LED: D1.1 (K), U1.34 (PB6C/PCLKT2_0)
/PH2: J1.31, U6.6 (A4)
/PH2in: U1.8 (PL3B), U6.14 (B4)
/RA0: U1.66 (PR3D), U2.23 (A0)
/RA1: U1.67 (PR3C), U2.24 (A1)
/RA2: U1.69 (PR3A), U2.25 (A2)
/RA3: U1.71 (PR2C), U2.26 (A3)
/RA4: U1.74 (PR2B), U2.29 (A4)
/RA5: U1.70 (PR2D), U2.30 (A5)
/RA6: U1.68 (PR3B), U2.31 (A6)
/RA7: U1.75 (PR2A), U2.32 (A7)
/RA8: U1.65 (PR5A), U2.33 (A8)
/RA9: U1.62 (PCLKC1_0/PR5D), U2.34 (A9)
/RA10: U1.64 (PR5B), U2.22 (A10)
/RA11: U1.59 (PR6B), U2.35 (A11)
/RCLK: R2.2, R12.1, U2.38 (CLK)
/RCLKout: R12.2, U1.60 (PR6A)
/RD0: U1.36 (PB10A), U2.2 (DQ0), U2.53 (DQ15)
/RD1: U1.37 (PB10B), U2.4 (DQ1), U2.51 (DQ14)
/RD2: U1.38 (PB10C/PCLKT2_1), U2.5 (DQ2), U2.50 (DQ13)
/RD3: U1.39 (PB10D/PCLKC2_1), U2.7 (DQ3), U2.48 (DQ12)
/RD4: U1.40 (PB12A), U2.8 (DQ4), U2.47 (DQ11)
/RD5: U1.41 (PB12B), U2.10 (DQ5), U2.45 (DQ10)
/RD6: U1.42 (PB12C), U2.11 (DQ6), U2.44 (DQ9)
/RD7: U1.43 (PB12D), U2.13 (DQ7), U2.42 (DQ8)
/R~CAS: U1.52 (PR7C), U2.17 (~CAS)
/R~CS: U1.57 (PR6D), U2.19 (~CS)
/R~RAS: U1.54 (PR7A), U2.18 (~RAS)
/R~WE: U1.49 (PB14D/SI/SISPI), U2.16 (~WE)
/TCK: C30.1, R10.2, R11.1, U1.91 (TCK/PT7C)
/TCKr: J2.1, R11.2
/TDI: J2.5, U1.94 (TDI/PT7B)
/TDO: J2.7, U1.95 (TDO/PT7A)
/TMS: J2.3, U1.90 (TMS/PT7D)
/~C60M: R2.1, R3.1, U10.4 (Y)
/~CCAS: J1.17, U6.7 (A5)
/~CCASin: U1.9 (PL3C), U6.13 (B5)
/~CRAS: J1.35, U7.2 (A0)
/~CRASin: R5.1, U1.17 (PL6B)
/~CROMSEL: J1.20
/~CSEL: J1.26, U9.2 (A)
/~FWE: J1.12, U6.2 (A0)
/~INIT: R9.2, U1.77 (~INIT/PT11C)
/~PROG: R7.2, U1.81 (~PROGRAM/PT10D)
/~WEin: U1.15 (PL5D), U6.18 (B0)
GND: C1.2, C2.2, C3.2, C4.2, C5.2, C6.2, C7.2, C8.2, C9.2, C10.2, C11.2, C12.2, C13.2, C14.2, C15.2, C16.2, C17.2, C18.2, C19.2, C20.2, C21.2, C22.2, C23.2, C24.2, C25.2, C26.2, C27.2, C28.2, C29.2, C30.2, H5.1, J1.1, J1.22, J1.23, J1.27, J1.34, J1.44, J2.2, J2.4, R10.1, U1.6 (GND), U1.22 (GND), U1.33 (GND), U1.44 (GND), U1.56 (GNDIO1), U1.72 (GNDIO1), U1.79 (GND), U1.92 (GND), U2.6 (VSSQ), U2.12 (VSSQ), U2.28 (VSS), U2.36 (A12), U2.41 (VSS), U2.46 (VSSQ), U2.52 (VSSQ), U2.54 (VSS), U3.2 (GND), U4.1 (AtoB), U4.10 (GND), U5.10 (GND), U5.19 (~OE), U6.10 (GND), U6.19 (~OE), U7.10 (GND), U7.19 (~OE), U8.1 (GND), U9.3 (GND), U10.3 (GND), U11.2 (GND)
unnamed: D1.2 (A), R6.1
unnamed: U4.19 (~OE), U9.4 (Y)
unnamed: R5.2, U7.18 (B0)


Notes on the sheet:
col. addr.
CKE
30ns
NOP
~{RAS}r3
row
row addr.
~{RAS}
PHI2
CMD (rd)
~{RAS}r2
PCa
ACT
read data
PHI2in
D (wr)
CKEn-1
col.
D (rd)
RD (wr)
Early Align Write
Late Align Write
~{RAS}r
bank
write data
CKEEN
Early Align Read
~{RAS}in
MAin
Late Align Read
old row
prev. row
RD (rd)

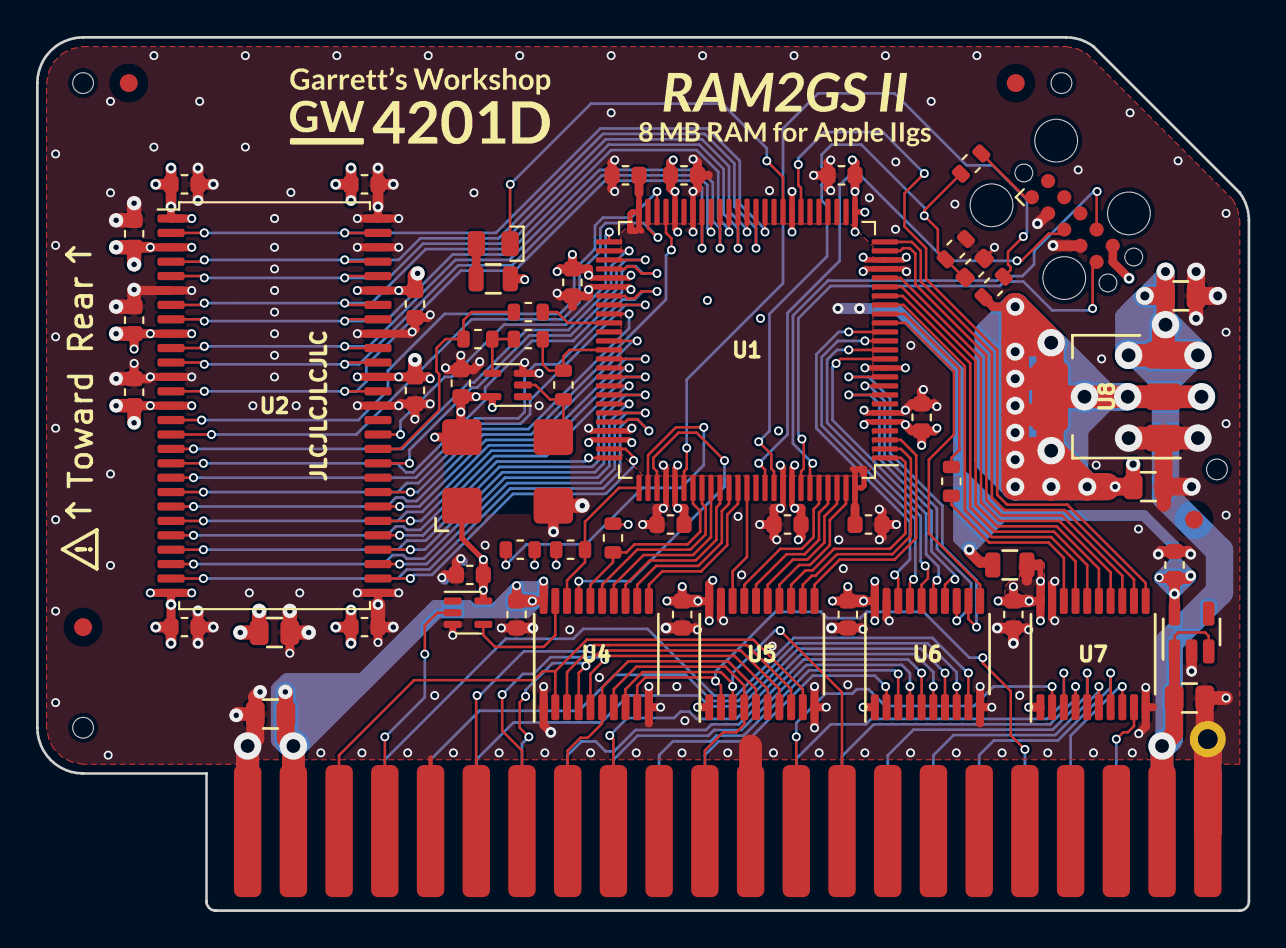
[picture p17: board Hardware/LCMXO2/RAM2GS.kicad_pcb from above]

Board: 4 copper layers, 67.3 x 48.5 mm, 66 parts (0 on the bottom side), 106 nets.
