garrettsworkshop/RAM2GS/Hardware/MachXO/RAM2GS.kicad_pcb

## KiCad design Hardware/MachXO/RAM2GS.kicad_pcb (2021-04-29)

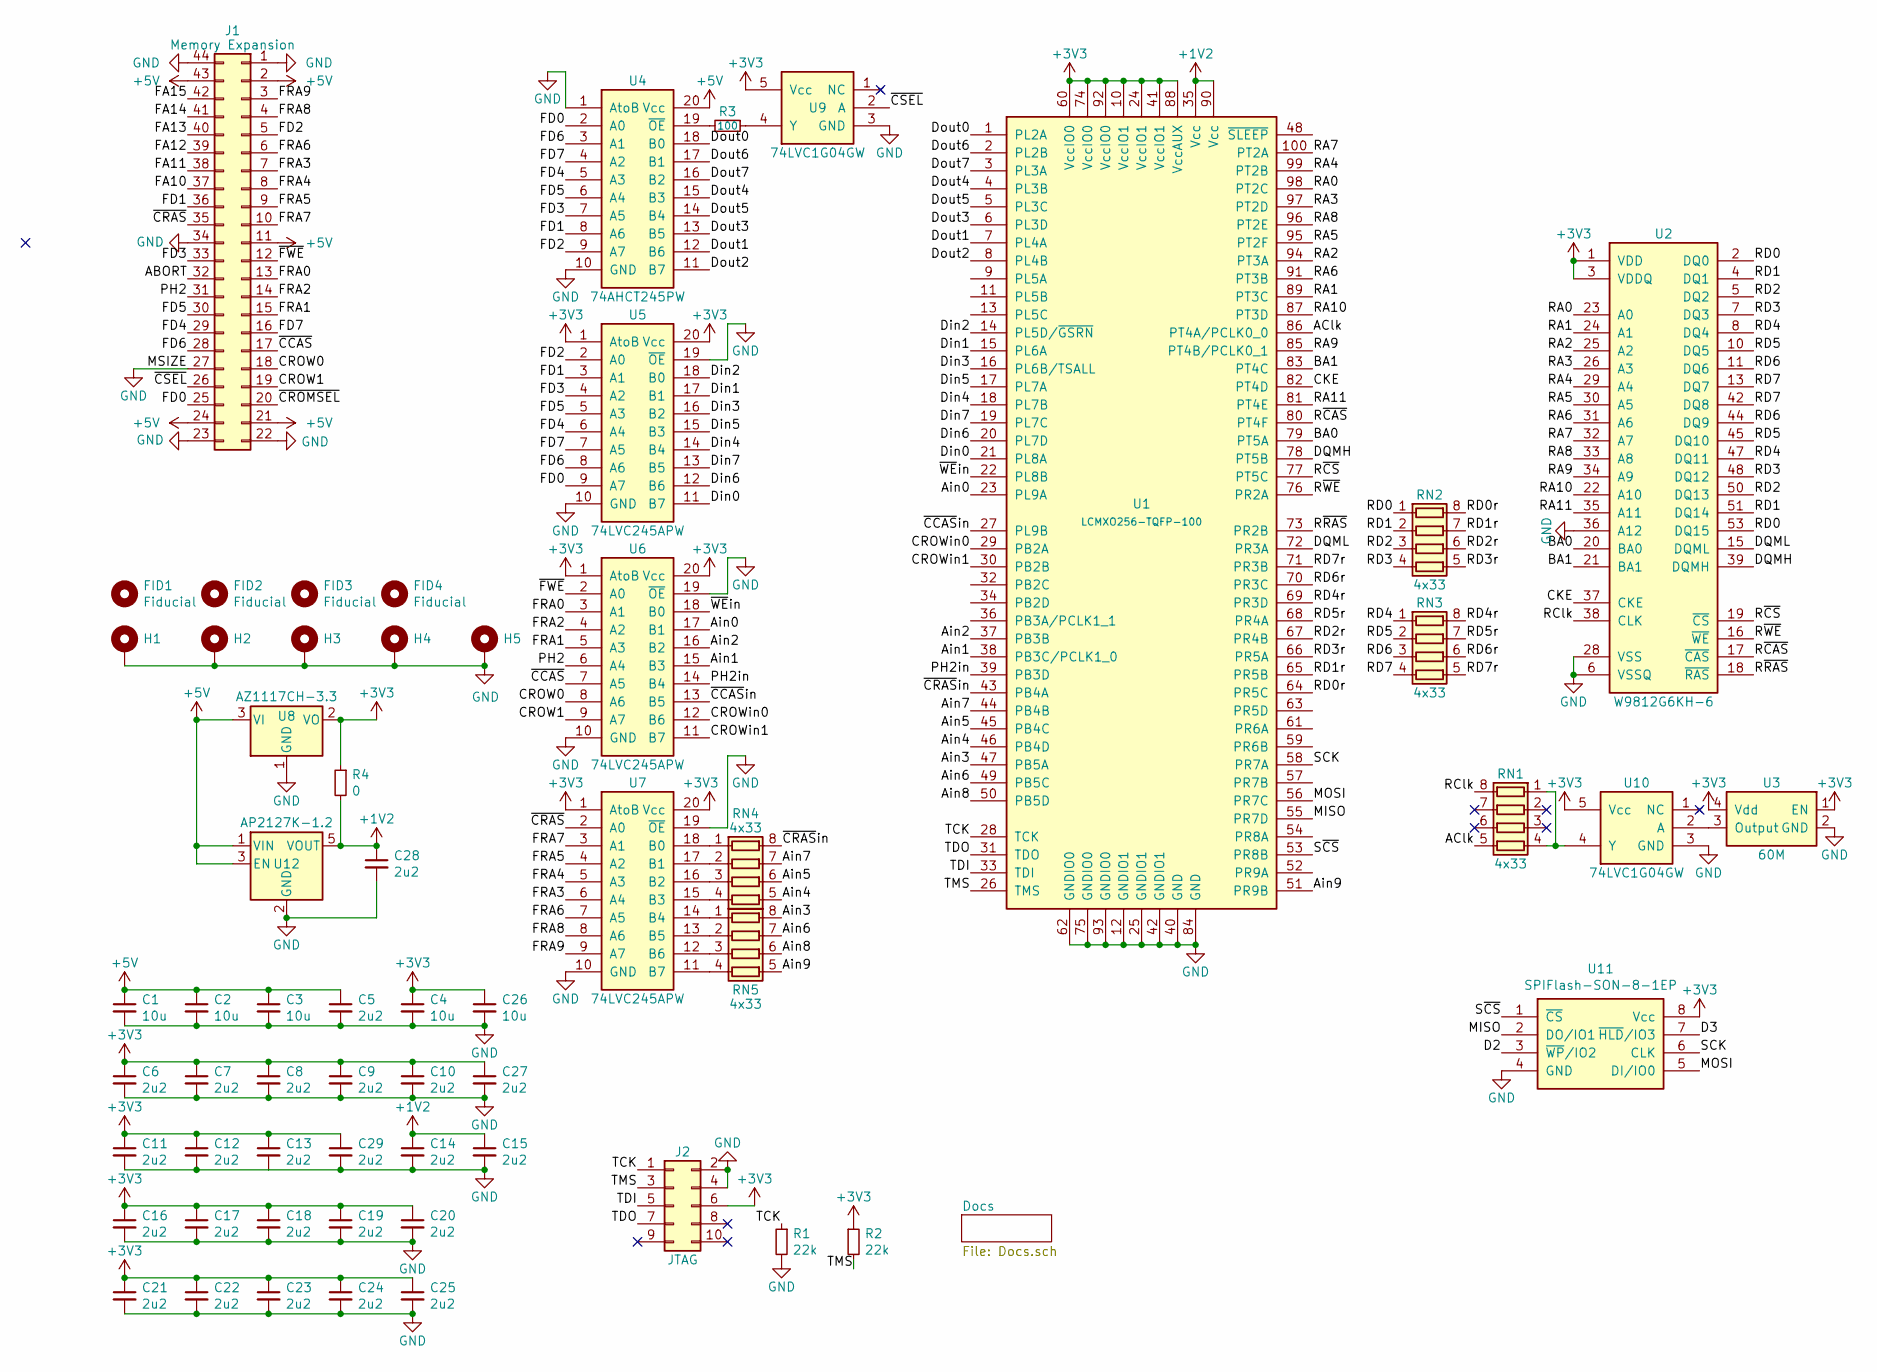
[picture p18: schematic RAM2GS.sch, GW4201D (RAM2GS II) - LCMXO256]

Parts:
C1, C2, C3, C4, C26: 10u; C_0805; LCSC Part C15850
C5, C6, C7, C8, C9, C10, C11, C12, C13, C14, C15, C16, C17, C18, C19, C20, C21, C22, C23, C24, C25, C27, C28, C29: 2u2; C_0603; LCSC Part C23630
FID1, FID2, FID3, FID4: Fiducial
H1, H2, H4, H5: PasteHole_1.152mm_NPTH
H3: PasteHole_1.1mm_PTH
J1: Memory Expansion; AppleIIgsMemoryExpansion_Edge
J2: JTAG; Tag-Connect_TC2050-IDC-FP_2x05_P1.27mm_Vertical
R1, R2: 22k; R_0805; LCSC Part C17560
R3: 100; R_0805; LCSC Part C17408
R4: 0; R_0805; LCSC Part C17477
RN1, RN2, RN3, RN4, RN5: 4x33; R4_0402; LCSC Part C25501
U1: LCMXO256-TQFP-100; TQFP-100_14x14mm_P0.5mm
U2: W9812G6KH-6; TSOP-II-54_22.2x10.16mm_P0.8mm; Mfg. Part Numbers Winbond W9812G6KH-6 Winbond W9812G6KH-6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; LCSC Part C62379
U3: 60M; Crystal_SMD_7050-4Pin_7.0x5.0mm_SiTime; Mfg. Part Numbers SiTime SIT1602AI-82-33E-60.000000Y; LCSC Part C26255
U4: 74AHCT245PW; TSSOP-20_4.4x6.5mm_P0.65mm; Mfg. Part Numbers NXP 74AHCT245PW TI SN74AHCT245PW; LCSC Part C173388
U5, U6, U7: 74LVC245APW; TSSOP-20_4.4x6.5mm_P0.65mm; Mfg. Part Numbers NXP 74LVC245APW TI SN74LVC245APW; LCSC Part C6082
U8: AZ1117CH-3.3; SOT-223; Mfg. Part Numbers Diodes AZ1117CH-3.3TR1G Diodes AZ1117EH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; LCSC Part C92102
U9, U10: 74LVC1G04GW; SOT-353; Mfg. Part Numbers NXP 74LVC1G04GW TI SN74LVC1G04DCK; LCSC Part C10237
U11: SPIFlash-SON-8-1EP; SON-8-1EP_3x2mm_P0.5mm_EP0.25x1.65mm
U12: AP2127K-1.2; SOT-23-5

Connections:
+1V2: C14.1, C15.1, C28.1, R4.2, U1.35 (Vcc), U1.90 (Vcc), U12.5 (VOUT)
+3V3: C4.1, C6.1, C7.1, C8.1, C9.1, C10.1, C11.1, C12.1, C13.1, C16.1, C17.1, C18.1, C19.1, C20.1, C21.1, C22.1, C23.1, C24.1, C25.1, C26.1, C27.1, C29.1, J2.6, R2.1, R4.1, U1.10 (VccIO1), U1.24 (VccIO1), U1.41 (VccIO1), U1.60 (VccIO0), U1.74 (VccIO0), U1.88 (VccAUX), U1.92 (VccIO0), U2.1 (VDD), U2.3 (VDDQ), U2.9 (VDDQ), U2.14 (VDD), U2.27 (VDD), U2.43 (VDDQ), U2.49 (VDDQ), U3.1 (EN), U3.4 (Vdd), U5.1 (AtoB), U5.20 (Vcc), U6.1 (AtoB), U6.20 (Vcc), U7.1 (AtoB), U7.20 (Vcc), U8.2 (VO), U9.5 (Vcc), U10.5 (Vcc), U11.8 (Vcc)
+5V: C1.1, C2.1, C3.1, C5.1, J1.2, J1.11, J1.21, J1.24, J1.43, U4.20 (Vcc), U8.3 (VI), U12.1 (VIN), U12.3 (EN)
/ABORT: J1.32
/AClk: RN1.5 (R4.2), U1.86 (PT4A/PCLK0_0)
/Ain0: U1.23 (PL9A), U6.17 (B1)
/Ain1: U1.38 (PB3C/PCLK1_0), U6.15 (B3)
/Ain2: U1.37 (PB3B), U6.16 (B2)
/Ain3: RN5.8 (R1.2), U1.47 (PB5A)
/Ain4: RN4.5 (R4.2), U1.46 (PB4D)
/Ain5: RN4.6 (R3.2), U1.45 (PB4C)
/Ain6: RN5.7 (R2.2), U1.49 (PB5C)
/Ain7: RN4.7 (R2.2), U1.44 (PB4B)
/Ain8: RN5.6 (R3.2), U1.50 (PB5D)
/Ain9: RN5.5 (R4.2), U1.51 (PR9B)
/BA0: U1.79 (PT5A), U2.20 (BA0)
/BA1: U1.83 (PT4C), U2.21 (BA1)
/CKE: U1.82 (PT4D), U2.37 (CKE)
/CROW0: J1.18, U6.8 (A6)
/CROW1: J1.19, U6.9 (A7)
/CROWin0: U1.29 (PB2A), U6.12 (B6)
/CROWin1: U1.30 (PB2B), U6.11 (B7)
/D2: U11.3 (~WP~/IO2)
/D3: U11.7 (~HLD~/IO3)
/DQMH: U1.78 (PT5B), U2.39 (DQMH)
/DQML: U1.72 (PR3A), U2.15 (DQML)
/Din0: U1.21 (PL8A), U5.11 (B7)
/Din1: U1.15 (PL6A), U5.17 (B1)
/Din2: U1.14 (PL5D/~GSRN~), U5.18 (B0)
/Din3: U1.16 (PL6B/TSALL), U5.16 (B2)
/Din4: U1.18 (PL7B), U5.14 (B4)
/Din5: U1.17 (PL7A), U5.15 (B3)
/Din6: U1.20 (PL7D), U5.12 (B6)
/Din7: U1.19 (PL7C), U5.13 (B5)
/Dout0: U1.1 (PL2A), U4.18 (B0)
/Dout1: U1.7 (PL4A), U4.12 (B6)
/Dout2: U1.8 (PL4B), U4.11 (B7)
/Dout3: U1.6 (PL3D), U4.13 (B5)
/Dout4: U1.4 (PL3B), U4.15 (B3)
/Dout5: U1.5 (PL3C), U4.14 (B4)
/Dout6: U1.2 (PL2B), U4.17 (B1)
/Dout7: U1.3 (PL3A), U4.16 (B2)
/FA10: J1.37
/FA11: J1.38
/FA12: J1.39
/FA13: J1.40
/FA14: J1.41
/FA15: J1.42
/FD0: J1.25, U4.2 (A0), U5.9 (A7)
/FD1: J1.36, U4.8 (A6), U5.3 (A1)
/FD2: J1.5, U4.9 (A7), U5.2 (A0)
/FD3: J1.33, U4.7 (A5), U5.4 (A2)
/FD4: J1.29, U4.5 (A3), U5.6 (A4)
/FD5: J1.30, U4.6 (A4), U5.5 (A3)
/FD6: J1.28, U4.3 (A1), U5.8 (A6)
/FD7: J1.16, U4.4 (A2), U5.7 (A5)
/FRA0: J1.13, U6.3 (A1)
/FRA1: J1.15, U6.5 (A3)
/FRA2: J1.14, U6.4 (A2)
/FRA3: J1.7, U7.6 (A4)
/FRA4: J1.8, U7.5 (A3)
/FRA5: J1.9, U7.4 (A2)
/FRA6: J1.6, U7.7 (A5)
/FRA7: J1.10, U7.3 (A1)
/FRA8: J1.4, U7.8 (A6)
/FRA9: J1.3, U7.9 (A7)
/MISO: U1.55 (PR7D), U11.2 (DO/IO1)
/MOSI: U1.56 (PR7C), U11.5 (DI/IO0)
/PH2: J1.31, U6.6 (A4)
/PH2in: U1.39 (PB3D), U6.14 (B4)
/RA0: U1.98 (PT2C), U2.23 (A0)
/RA1: U1.89 (PT3C), U2.24 (A1)
/RA2: U1.94 (PT3A), U2.25 (A2)
/RA3: U1.97 (PT2D), U2.26 (A3)
/RA4: U1.99 (PT2B), U2.29 (A4)
/RA5: U1.95 (PT2F), U2.30 (A5)
/RA6: U1.91 (PT3B), U2.31 (A6)
/RA7: U1.100 (PT2A), U2.32 (A7)
/RA8: U1.96 (PT2E), U2.33 (A8)
/RA9: U1.85 (PT4B/PCLK0_1), U2.34 (A9)
/RA10: U1.87 (PT3D), U2.22 (A10)
/RA11: U1.81 (PT4E), U2.35 (A11)
/RClk: RN1.8 (R1.2), U2.38 (CLK)
/RD0: RN2.1 (R1.1), U2.2 (DQ0), U2.53 (DQ15)
/RD0r: RN2.8 (R1.2), U1.64 (PR5C)
/RD1: RN2.2 (R2.1), U2.4 (DQ1), U2.51 (DQ14)
/RD1r: RN2.7 (R2.2), U1.65 (PR5B)
/RD2: RN2.3 (R3.1), U2.5 (DQ2), U2.50 (DQ13)
/RD2r: RN2.6 (R3.2), U1.67 (PR4B)
/RD3: RN2.4 (R4.1), U2.7 (DQ3), U2.48 (DQ12)
/RD3r: RN2.5 (R4.2), U1.66 (PR5A)
/RD4: RN3.1 (R1.1), U2.8 (DQ4), U2.47 (DQ11)
/RD4r: RN3.8 (R1.2), U1.69 (PR3D)
/RD5: RN3.2 (R2.1), U2.10 (DQ5), U2.45 (DQ10)
/RD5r: RN3.7 (R2.2), U1.68 (PR4A)
/RD6: RN3.3 (R3.1), U2.11 (DQ6), U2.44 (DQ9)
/RD6r: RN3.6 (R3.2), U1.70 (PR3C)
/RD7: RN3.4 (R4.1), U2.13 (DQ7), U2.42 (DQ8)
/RD7r: RN3.5 (R4.2), U1.71 (PR3B)
/R~CAS~: U1.80 (PT4F), U2.17 (~CAS~)
/R~CS~: U1.77 (PT5C), U2.19 (~CS~)
/R~RAS~: U1.73 (PR2B), U2.18 (~RAS~)
/R~WE~: U1.76 (PR2A), U2.16 (~WE~)
/SCK: U1.58 (PR7A), U11.6 (CLK)
/S~CS~: U1.53 (PR8B), U11.1 (~CS~)
/TCK: J2.1, R1.1, U1.28 (TCK)
/TDI: J2.5, U1.33 (TDI)
/TDO: J2.7, U1.31 (TDO)
/TMS: J2.3, R2.2, U1.26 (TMS)
/~CCAS~: J1.17, U6.7 (A5)
/~CCAS~in: U1.27 (PL9B), U6.13 (B5)
/~CRAS~: J1.35, U7.2 (A0)
/~CRAS~in: RN4.8 (R1.2), U1.43 (PB4A)
/~CROMSEL~: J1.20
/~CSEL~: J1.26, U9.2 (A)
/~FWE~: J1.12, U6.2 (A0)
/~WE~in: U1.22 (PL8B), U6.18 (B0)
GND: C1.2, C2.2, C3.2, C4.2, C5.2, C6.2, C7.2, C8.2, C9.2, C10.2, C11.2, C12.2, C13.2, C14.2, C15.2, C16.2, C17.2, C18.2, C19.2, C20.2, C21.2, C22.2, C23.2, C24.2, C25.2, C26.2, C27.2, C28.2, C29.2, H1.1, H2.1, H3.1, H4.1, H5.1, J1.1, J1.22, J1.23, J1.27, J1.34, J1.44, J2.2, J2.4, R1.2, U1.12 (GNDIO1), U1.25 (GNDIO1), U1.40 (GND), U1.42 (GNDIO1), U1.62 (GNDIO0), U1.75 (GNDIO0), U1.84 (GND), U1.93 (GNDIO0), U2.6 (VSSQ), U2.12 (VSSQ), U2.28 (VSS), U2.36 (A12), U2.41 (VSS), U2.46 (VSSQ), U2.52 (VSSQ), U2.54 (VSS), U3.2 (GND), U4.1 (AtoB), U4.10 (GND), U5.10 (GND), U5.19 (~OE~), U6.10 (GND), U6.19 (~OE~), U7.10 (GND), U7.19 (~OE~), U8.1 (GND), U9.3 (GND), U10.3 (GND), U11.4 (GND), U11.9 (GND), U12.2 (GND)
unnamed: R3.1, U9.4 (Y)
unnamed: R3.2, U4.19 (~OE~)
unnamed: RN1.1 (R1.1), RN1.4 (R4.1), U10.4 (Y)
unnamed: RN4.1 (R1.1), U7.18 (B0)
unnamed: RN4.2 (R2.1), U7.17 (B1)
unnamed: RN4.3 (R3.1), U7.16 (B2)
unnamed: RN4.4 (R4.1), U7.15 (B3)
unnamed: RN5.1 (R1.1), U7.14 (B4)
unnamed: RN5.2 (R2.1), U7.13 (B5)
unnamed: RN5.3 (R3.1), U7.12 (B6)
unnamed: RN5.4 (R4.1), U7.11 (B7)
unnamed: U3.3 (Output), U10.2 (A)

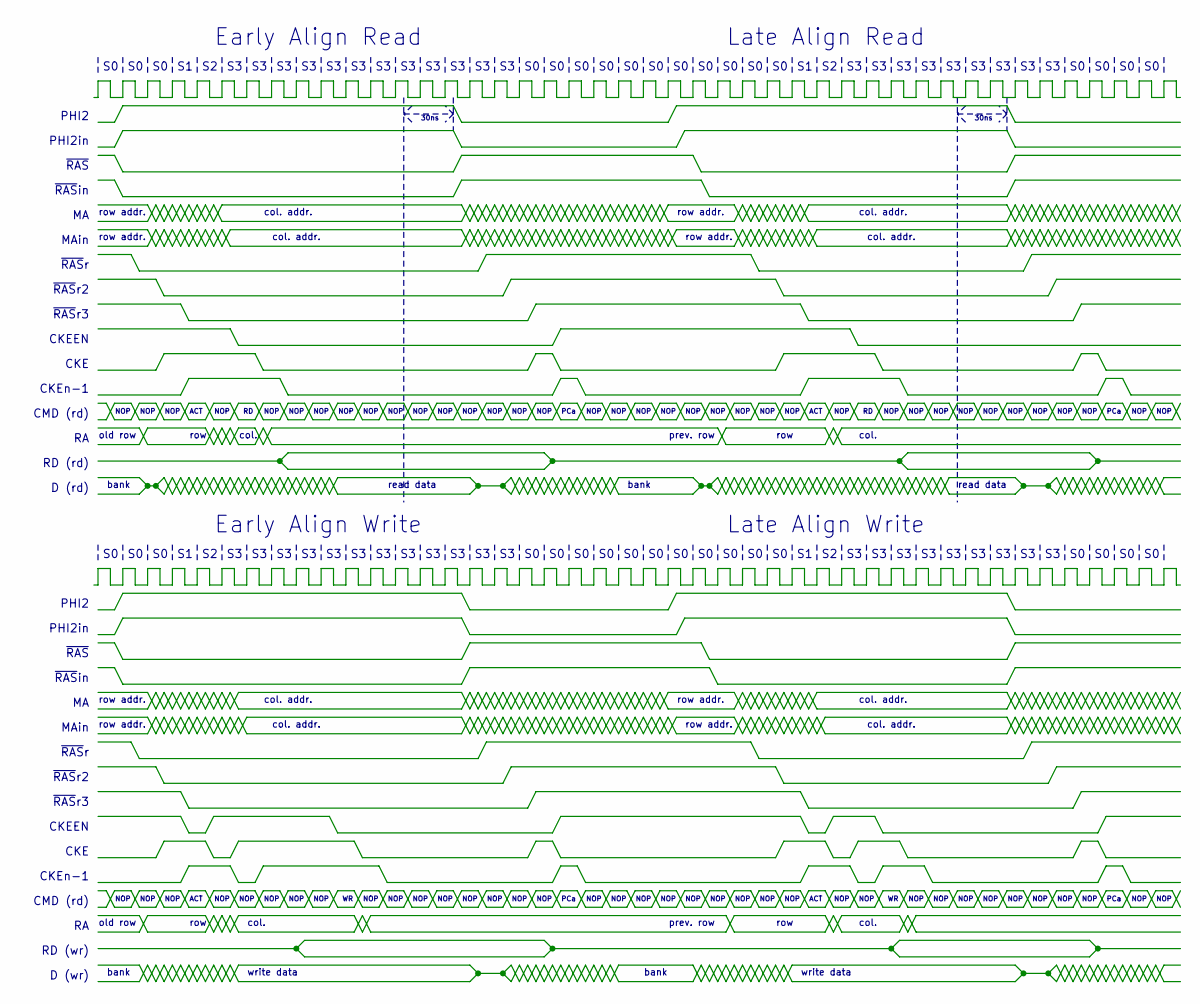
[picture p19: schematic Docs.sch, GW4201D (RAM2GS II) - LCMXO256]

Notes on the sheet:
Early Align Read
Late Align Read
30ns
PHI2
PHI2in
row addr.
col. addr.
MAin
~RAS~
~RAS~in
~RAS~r
CKE
NOP
CKEEN
prev. row
row
col.
old row
bank
read data
D (rd)
RD (rd)
CMD (rd)
ACT
PCa
RD (wr)
D (wr)
write data
Late Align Write
Early Align Write
~RAS~r2
CKEn-1
~RAS~r3

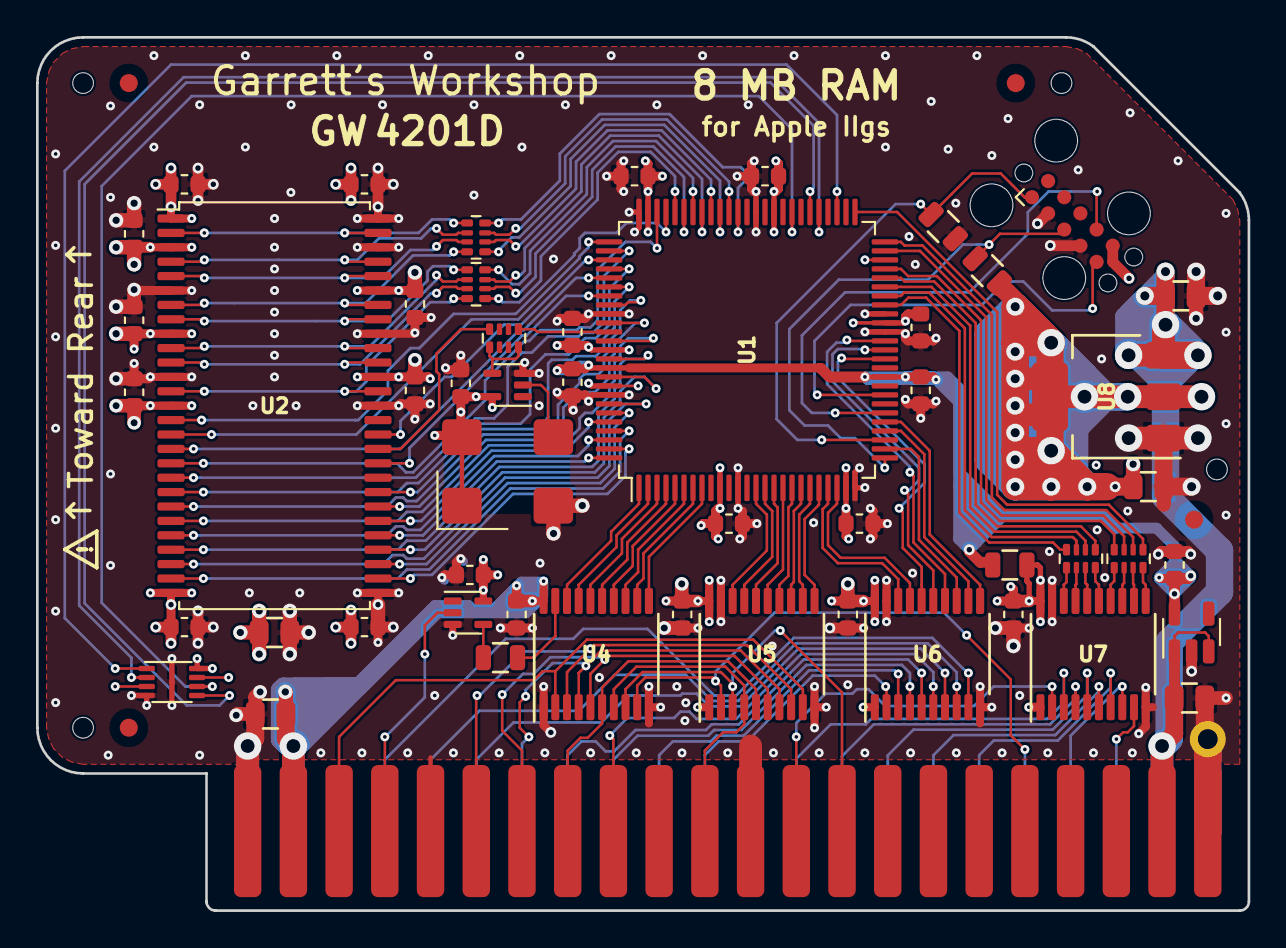
[picture p20: board Hardware/MachXO/RAM2GS.kicad_pcb from above]

Board: 4 copper layers, 67.3 x 48.5 mm, 61 parts (0 on the bottom side), 120 nets.
