garrettsworkshop/RAM2GS/(commit log)

2020-07-25 Add GW4201D files
    [Docs.sch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]
2020-08-02 Documentation update
    [Docs.sch, RAM2GS.kicad_pcb, RAM2GS.sch]
2020-08-05 Fixed W9812/W9825 footprint
    [RAM2GS.sch]
2020-09-29 Switch to 7050 oscillator
    [RAM2GS.kicad_pcb, RAM2GS.sch]
2020-10-06 Fabbed 10/6/2020
    [Docs.sch, RAM2GS-BOM.csv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]
2021-04-29 Added 1.8V regulator
    [Docs.sch, RAM2GS.kicad_pcb, RAM2GS.sch]
2021-04-29 Create folders for all board layouts
    [Docs.sch, RAM2GS-BOM.csv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]
2021-05-01 finished MAX, LCMXO, iCE40?
    [Docs.sch, RAM2GS-BOM-5M240Z.csv, RAM2GS-BOM-AG256.csv, RAM2GS-BOM-EPM240.csv, RAM2GS-BOM-LCMXO256C.csv, RAM2GS-BOM-LCMXO256E.csv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]
2021-05-07 almost done
    [RAM2GS-BOM-5M240Z.csv, RAM2GS-BOM-AG256.csv, RAM2GS-BOM-EPM240.csv, RAM2GS-BOM-LCMXO2_HC.csv, RAM2GS-BOM-LCMXO2_ZE.csv, RAM2GS-BOM-LCMXO_C.csv, RAM2GS-BOM-LCMXO_E.csv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]
2021-05-31 Generated gerbers and documenation PDFs
    [Docs.sch, RAM2GS-BOM-5M240Z.csv, RAM2GS-BOM-AG256.csv, RAM2GS-BOM-EPM240.csv, RAM2GS-BOM-LCMXO2_HC.csv, RAM2GS-BOM-LCMXO2_ZE.csv, RAM2GS-BOM-LCMXO_C.csv, RAM2GS-BOM-LCMXO_E.csv]
2021-05-31 Created BOMs
    [RAM2GS-BOM. LCMXO2HE.csv, RAM2GS-BOM. LCMXO2ZE.csv, RAM2GS-BOM.LCMXO2HC.csv, RAM2GS-BOM.LCMXOC.csv, RAM2GS-BOM.LCMXOE.csv, RAM2GS-BOM.MAXII.csv, RAM2GS-BOM.MAXIIG.csv, RAM2GS-BOM.MAXIIZ.csv]
2021-06-01 Updated LCMXO2 board, fixed GND via
    [RAM2GS-B_Cu.gbl, RAM2GS-B_Mask.gbs, RAM2GS-B_SilkS.gbo, RAM2GS-Edge_Cuts.gm1, RAM2GS-F_Cu.gtl, RAM2GS-F_Fab.gbr, RAM2GS-F_Mask.gts, RAM2GS-F_Paste.gtp]
2021-06-01 Updated pos files
    [RAM2GS-bottom-pos.csv, RAM2GS-top-pos.csv]
2021-06-01 Remove 3d models for DNP parts
    [RAM2GS.kicad_pcb]
2021-06-01 BOM fixes
    [RAM2GS-BOM.AGM.csv, RAM2GS.sch]
2021-08-06 LED stuff
2021-10-29 Fix LCMXO2 clock pin. Gerbers done.
    [RAM2GS-B_Cu.gbl, RAM2GS-B_Mask.gbs, RAM2GS-B_SilkS.gbo, RAM2GS-Edge_Cuts.gm1, RAM2GS-F_Cu.gtl, RAM2GS-F_Fab.gbr, RAM2GS-F_Mask.gts, RAM2GS-F_Paste.gtp]
2023-08-13 Loads LED setting from UFM. On by defualt.
2023-08-13 Led done?
2023-08-15 All compiling
    [RAM2GS_LCMXO256C_impl1_mapvho.sdf, RAM2GS_LCMXO256C_impl1_mapvo.sdf, RAM2GS_LCMXO2_1200HC_impl1_mapvho.sdf, RAM2GS_LCMXO2_1200HC_impl1_mapvo.sdf, RAM2GS_LCMXO2_640HC_impl1_mapvho.sdf, RAM2GS_LCMXO2_640HC_impl1_mapvo.sdf, RAM2GS_LCMXO640C_impl1_mapvho.sdf, RAM2GS_LCMXO640C_impl1_mapvo.sdf]
2023-08-17 MachXO2 stuff
    [LCMXO2_640HC_impl1_comp.rt.csv, RAM2GS_LCMXO2_640HC_impl1_mapvho.sdf, RAM2GS_LCMXO2_640HC_impl1_mapvo.sdf, impl1_comp.rt.csv]
2023-08-20 MAX, MachXO, MachXO2 working
    [LCMXO2_640HC_impl1_comp.rt.csv, LCMXO2_640HC_impl1_mapvho.sdf, LCMXO2_640HC_impl1_mapvo.sdf, LCMXO2_640HC_impl1_vho.sdf, LCMXO2_640HC_impl1_vo.sdf, RAM2GS_LCMXO256C_impl1_comp.rt.csv, RAM2GS_LCMXO256C_impl1_mapvho.sdf, RAM2GS_LCMXO256C_impl1_mapvo.sdf]
2023-09-29 Fixed failure to rewrite settings after UFM erase
    [RAM2GS-MAX.v]
2023-09-29 Gate LED with Ready signal
2023-11-07 LCMXO2: Add R12 and R13 to LCMXO2ZE BOM
    [RAM2GS-BOM. LCMXO2ZE.csv]
2023-11-07 Fix LCMXO2ZE BOM filename
    [RAM2GS-BOM.LCMXO2ZE.csv]
2023-11-11 Fixed LED and current-limiting resistor values in BOM
    [RAM2GS-BOM.LCMXO2HC.csv, RAM2GS-BOM.LCMXO2ZE.csv, RAM2GS-BOM.LCMXOC.csv, RAM2GS-BOM.LCMXOE.csv, RAM2GS-BOM.MAXII.csv, RAM2GS-BOM.MAXV.csv]
2024-01-07 SPI/LCMXO RC
    [RAM2GS_LCMXO256C_impl1_mapvo.sdf, RAM2GS_LCMXO256C_impl1_vo.sdf, RAM2GS_LCMXO2_1200HC_impl1_mapvo.sdf, RAM2GS_LCMXO2_1200HC_impl1_vo.sdf, RAM2GS_LCMXO2_640HC_impl1_mapvo.sdf, RAM2GS_LCMXO2_640HC_impl1_vo.sdf, RAM2GS_LCMXO640C_impl1_mapvo.sdf, RAM2GS_LCMXO640C_impl1_vo.sdf]
2024-04-24 RC 2.2
    [Docs.kicad_sch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]
2024-04-24 RC
    Remove MachXO crystal oscillator EN jumper under keepout area
    Remvoe DNP 3d models on MachXO2
    [RAM2GS-B_Cu.gbl, RAM2GS-B_Mask.gbs, RAM2GS-B_Silkscreen.gbo, RAM2GS-Edge_Cuts.gm1, RAM2GS-F_Cu.gtl, RAM2GS-F_Mask.gts, RAM2GS-F_Paste.gtp, RAM2GS-F_Silkscreen.gto]
2024-10-02 Add LCMXO2 internal oscillator firmware build
    [RAM2GS-LCMXO2-IntOsc.v]
2025-02-23 RC D.2.3
    [Docs.kicad_sch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]
